simu18/SpyScan/hardware/README.md

# hardware

Placeholder — content is added in the corresponding project stage (see docs/plan/WORK_PLAN.md).
