simu18/SpyScan/firmware/README.md

# firmware

Placeholder — content is added in the corresponding project stage (see docs/plan/WORK_PLAN.md).
