simu18/SpyScan/tools/README.md

# tools

Placeholder — content is added in the corresponding project stage (see docs/plan/WORK_PLAN.md).
