simu18/SpyScan/docs/architecture/README.md

# architecture

Placeholder — content is added in the corresponding project stage (see docs/plan/WORK_PLAN.md).
