simu18/SpyScan/docs/analysis/README.md

# analysis

Placeholder — content is added in the corresponding project stage (see docs/plan/WORK_PLAN.md).
