simu18/SpyScan/docs/architecture/img/01_hw_block.png

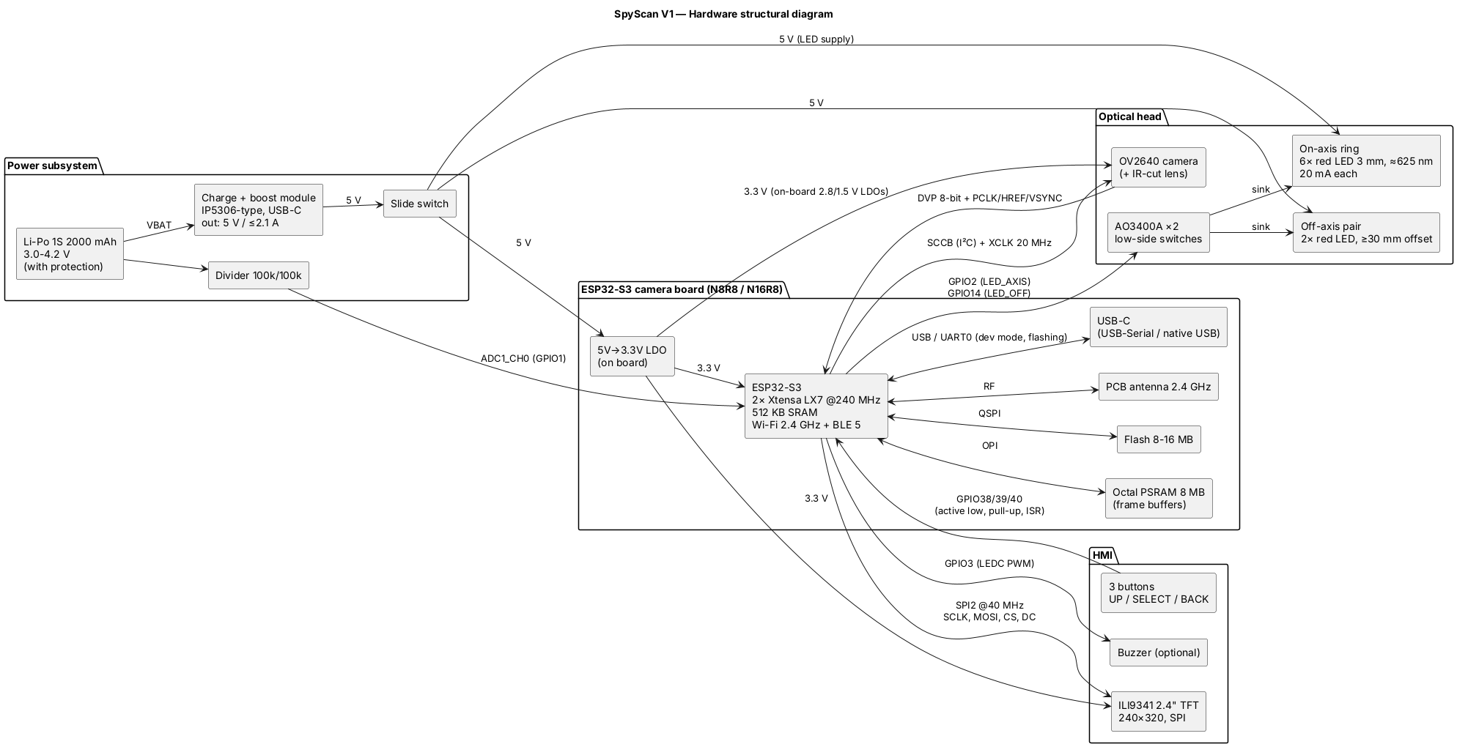
docs/architecture/img/01_hw_block.png
