simu18/SpyScan/docs/architecture/img/02_sw_modules.png

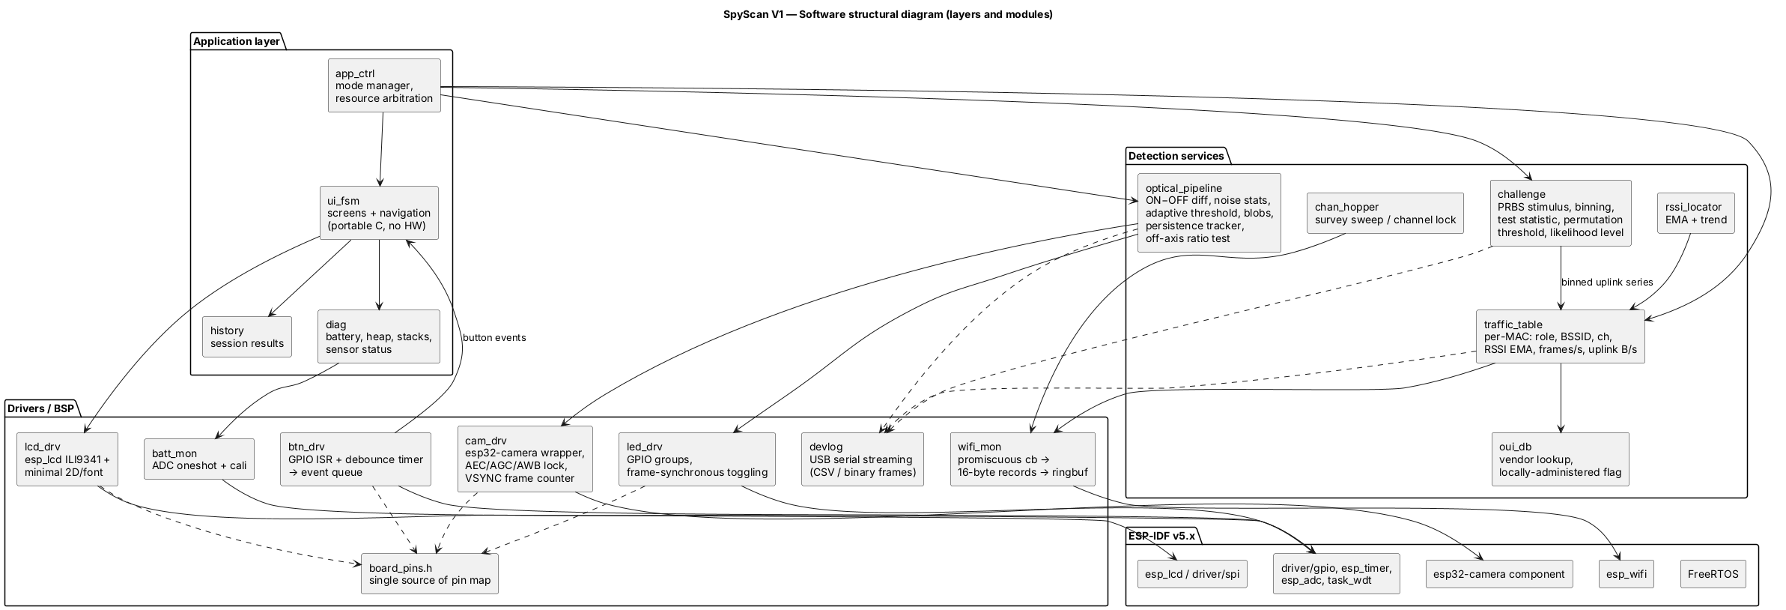
docs/architecture/img/02_sw_modules.png
