simu18/SpyScan/docs/architecture/img/03_rtos_tasks.png

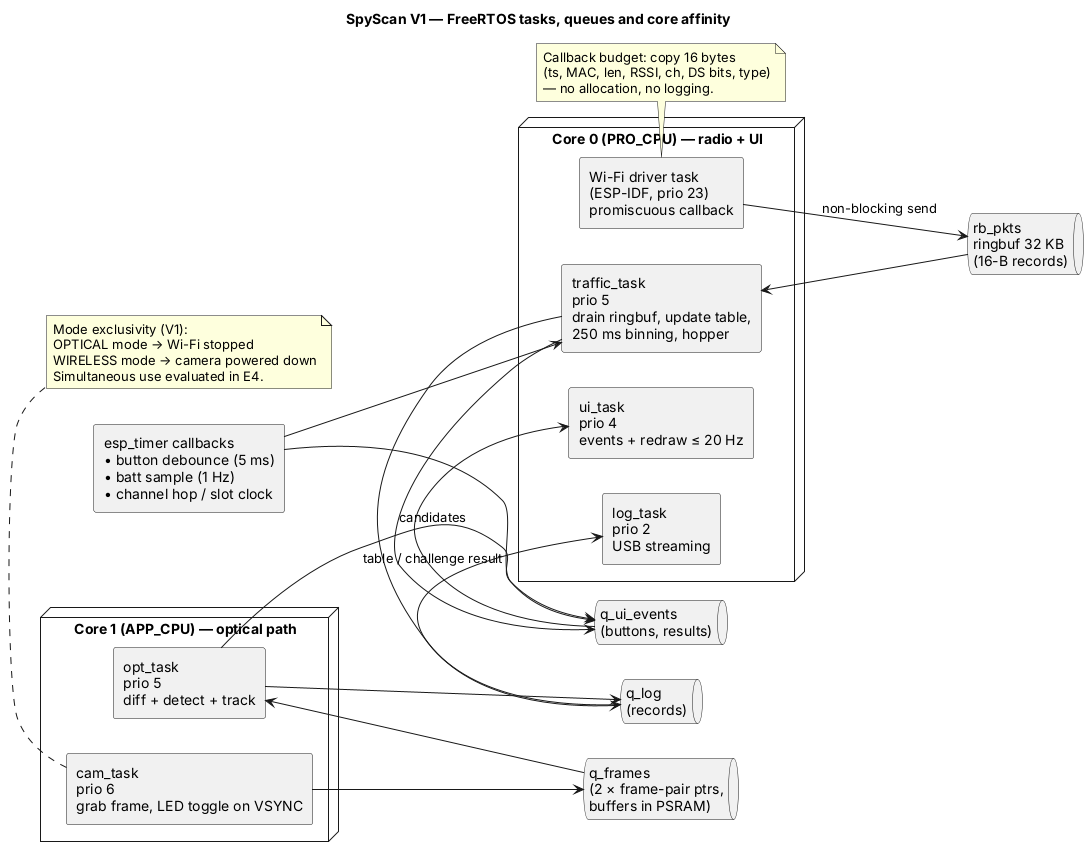
docs/architecture/img/03_rtos_tasks.png
