simu18/SpyScan/docs/architecture/img/04_seq_optical.png

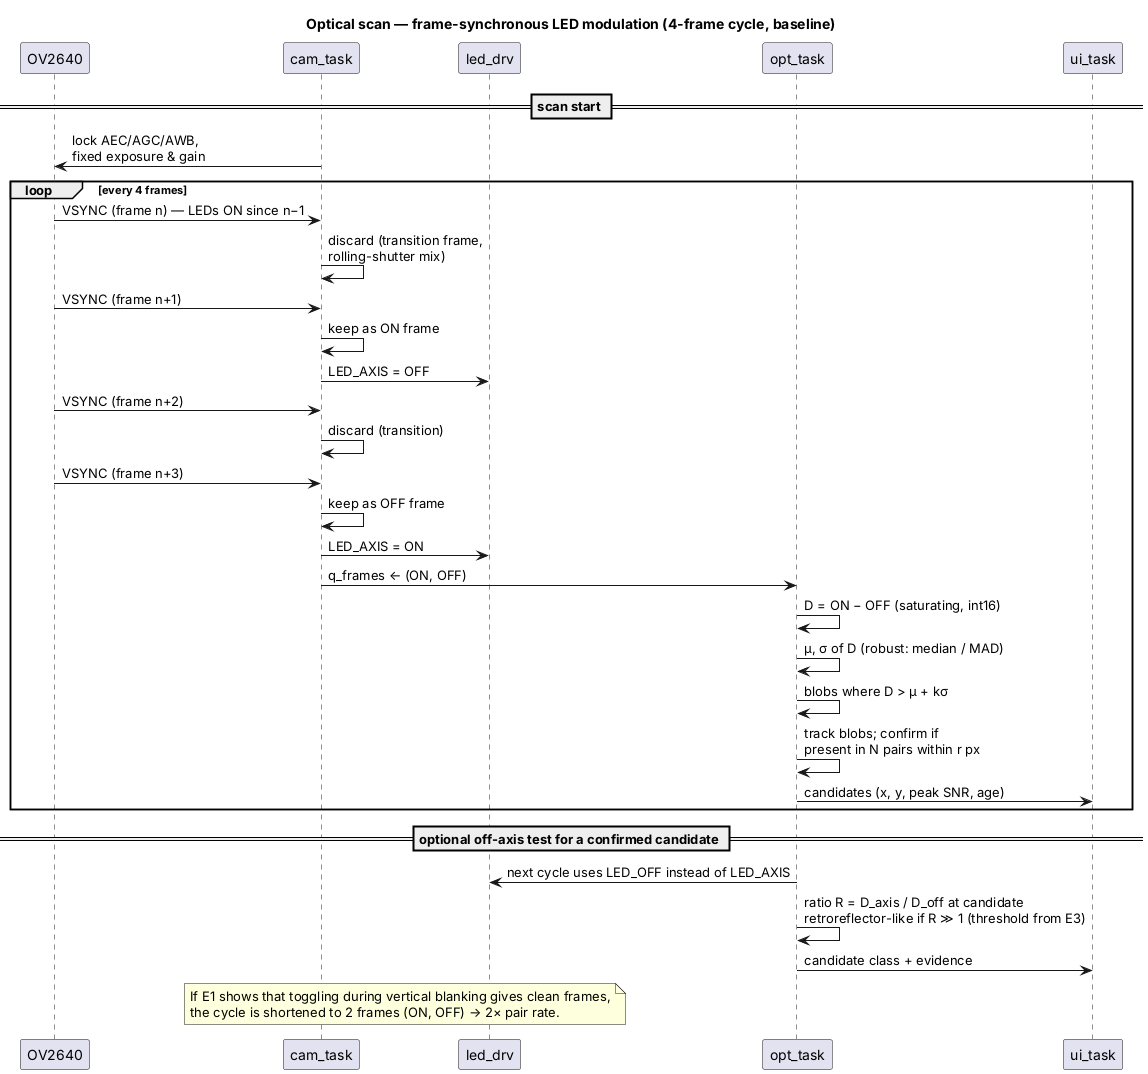
docs/architecture/img/04_seq_optical.png
