simu18/SpyScan/docs/architecture/img/05_seq_challenge.png

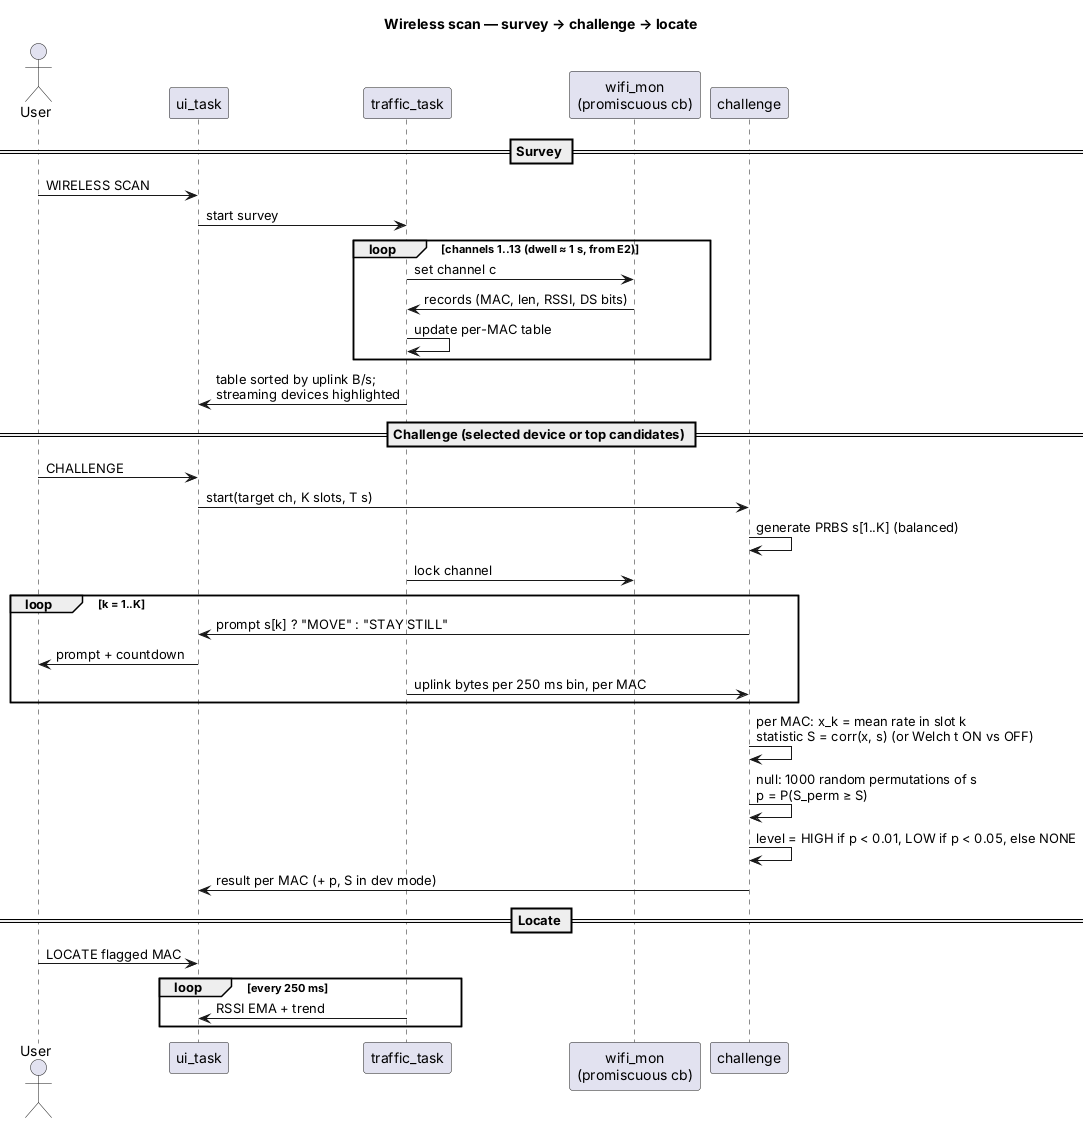
docs/architecture/img/05_seq_challenge.png
