simu18/SpyScan/docs/architecture/img/06_ui_fsm.png

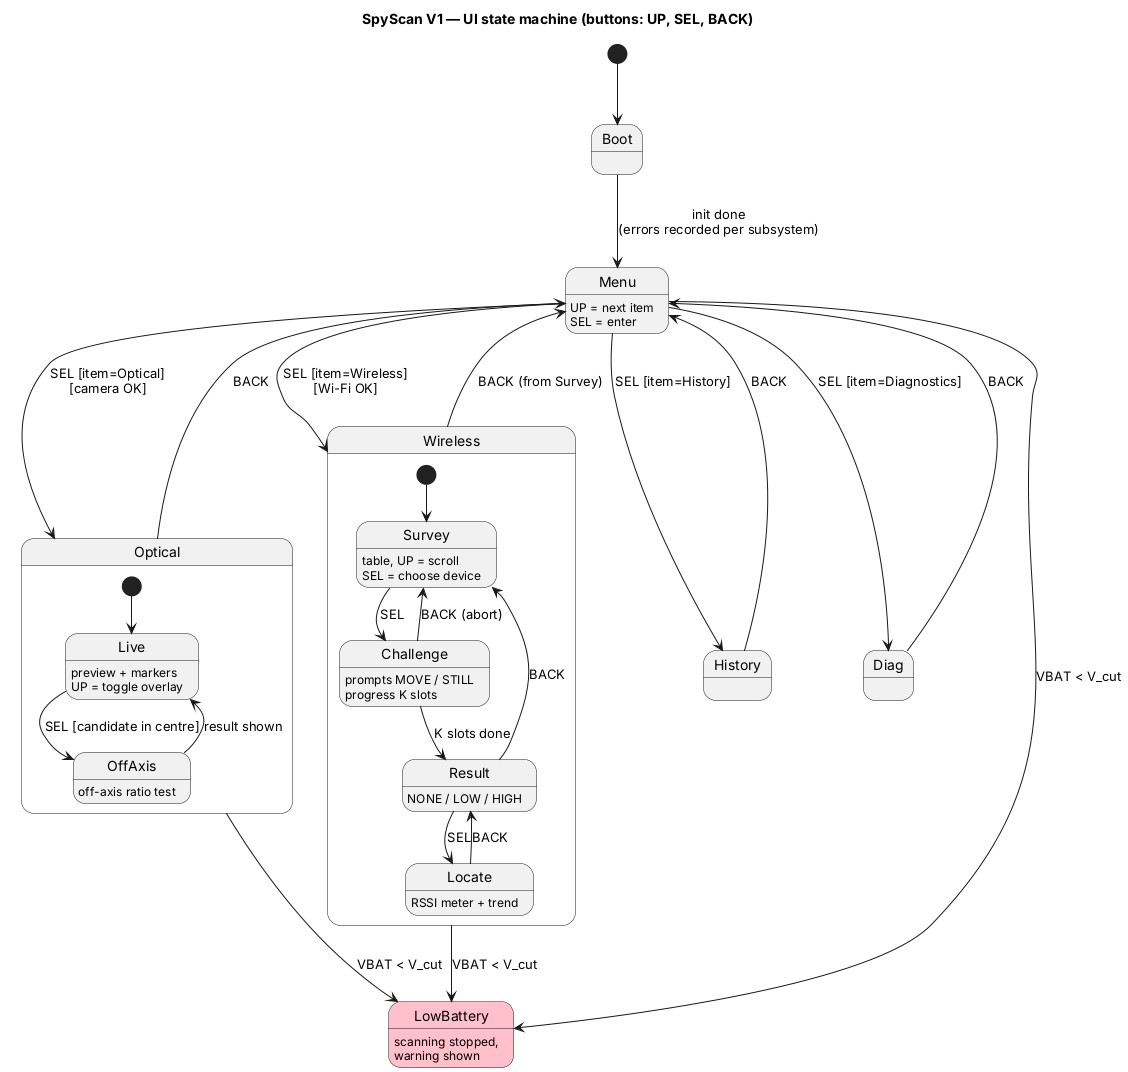
docs/architecture/img/06_ui_fsm.png
