simu18/SpyScan/hardware/spyscan_back_shell.stl

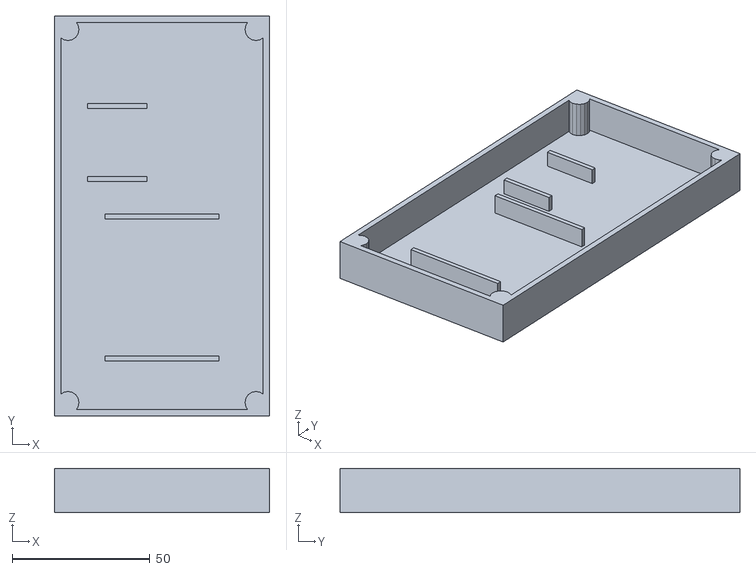
[picture p10: CAD file, 2026-11-08]
hardware/spyscan_back_shell.stl
78.0 x 145.0 x 16.0
