simu18/SpyScan/experiments/E2_wifi_traffic/data/20261023_030848_flash_stimulus/RESULTS.md

# Method 1: Optical-to-Wi-Fi Flash Stimulus Verification

- Target MAC: `cc:b8:5e:ad:5c:4a`
- Channel: 10
- Trials: 1
- Baseline Bitrate: **1.0 kB/s**
- Peak Post-Flash Bitrate: **2.8 kB/s** (+2.67×)
- Latency: **50 ms**
- Permutation p-value: **0.0307**

### Verdict: **CORRELATED (Optical Sensor belongs to Wi-Fi Transmitter)**
