simu18/SpyScan/experiments/E2_wifi_traffic/data/20261008_225613_record/RESULTS.md

# E2 run `20261008_225613_record`

- mode: **record**, channel: 10, bin: 100 ms, lines: 796
- duration: 20.7 s, devices seen: 8, APs: 13

## Busiest transmitters

| MAC | vendor hint | role | ch | tx kB/s | rx kB/s | tx frames | RSSI |
|---|---|---|---|---|---|---|---|
| `46:88:44:6e:4f:e4` | (random) | S | 10 | 55.39 | 0.03 | 1631 | -30 |
| `5c:62:8b:66:67:d2` |  | A | 10 | 3.28 | 56.68 | 89 | -48 |
| `72:3b:01:24:b7:c8` | (random) | S | 10 | 0.89 | 3.25 | 659 | -21 |
| `b2:db:ca:e6:29:a6` | (random) | S | 10 | 0.40 | 0.00 | 295 | -27 |
| `a6:4c:bd:b6:c7:99` | (random) | S | 10 | 0.09 | 0.00 | 32 | -88 |
| `78:8c:b5:f5:e7:26` |  | A | 10 | 0.03 | 0.10 | 6 | -74 |
| `64:d1:54:63:44:f4` |  | A | 10 | 0.01 | 0.00 | 3 | -86 |
| `00:08:22:24:d6:fb` |  | S | 10 | 0.00 | 0.00 | 1 | -86 |
