simu18/SpyScan/experiments/E2_wifi_traffic/data/20261023_023756_flash_stimulus/RESULTS.md

# Method 1: Optical-to-Wi-Fi Flash Stimulus Verification

- Target MAC: `cc:b8:5e:ad:5c:4a`
- Channel: 10
- Trials: 6
- Baseline Bitrate: **146.6 kB/s**
- Peak Post-Flash Bitrate: **206.7 kB/s** (+1.41×)
- Latency: **150 ms**
- Permutation p-value: **0.6500**

### Verdict: **UNCORRELATED (No significant bitrate spike observed)**
