simu18/SpyScan/experiments/E2_wifi_traffic/data/20261008_225257_challenge/RESULTS.md

# E2 run `20261008_225257_challenge`

- mode: **challenge**, channel: 10, bin: 100 ms, lines: 3647
- duration: 82.5 s, devices seen: 17, APs: 13

## Busiest transmitters

| MAC | vendor hint | role | ch | tx kB/s | rx kB/s | tx frames | RSSI |
|---|---|---|---|---|---|---|---|
| `46:88:44:6e:4f:e4` | (random) | S | 10 | 53.75 | 0.04 | 6409 | -28 |
| `5c:62:8b:66:67:d2` |  | A | 10 | 20.59 | 55.12 | 1558 | -48 |
| `72:3b:01:24:b7:c8` | (random) | S | 10 | 0.88 | 6.12 | 2604 | -21 |
| `78:8c:b5:f5:e7:26` |  | A | 10 | 0.87 | 0.19 | 83 | -73 |
| `b2:db:ca:e6:29:a6` | (random) | S | 10 | 0.48 | 14.43 | 1353 | -28 |
| `a6:4c:bd:b6:c7:99` | (random) | S | 10 | 0.18 | 0.81 | 360 | -84 |
| `80:af:ca:68:4c:f8` |  | A | 10 | 0.02 | 0.00 | 13 | -84 |
| `00:08:22:24:d6:fb` |  | S | 10 | 0.01 | 0.00 | 16 | -86 |
| `38:d5:7a:f4:5a:37` |  | S | 10 | 0.01 | 0.00 | 18 | -93 |
| `64:d1:54:63:44:f4` |  | A | 10 | 0.00 | 0.00 | 2 | -86 |
| `f4:28:9d:ce:e6:09` |  | S | 1 | 0.00 | 0.00 | 5 | -83 |
| `08:9d:f4:81:f5:38` |  | S | 1 | 0.00 | 0.00 | 2 | -87 |

## Challenge (K = 12, T = 5.0 s, lag = 0 ms, 10000 permutations)

Stimulus: `110101100001`

| MAC | vendor | S (corr) | p | level | tx ON kB/s | tx OFF kB/s | ON/OFF | direction |
|---|---|---|---|---|---|---|---|---|
| `78:8c:b5:f5:e7:26` |  | +0.377 | 0.1246 | **NONE** | 0.10 | 0.05 | 2.20 | - |
| `46:88:44:6e:4f:e4` | (random) | +0.058 | 0.4247 | **NONE** | 55.03 | 54.76 | 1.00 | - |
| `72:3b:01:24:b7:c8` | (random) | -0.029 | 0.5358 | **NONE** | 0.85 | 0.85 | 0.99 | - |
| `5c:62:8b:66:67:d2` |  | -0.290 | 0.6460 | **NONE** | 2.37 | 40.85 | 0.06 | - |
| `a6:4c:bd:b6:c7:99` | (random) | -0.147 | 0.7022 | **NONE** | 0.14 | 0.18 | 0.77 | - |
| `b2:db:ca:e6:29:a6` | (random) | -0.444 | 0.9559 | **NONE** | 0.43 | 0.52 | 0.82 | - |

*Measured data from this run. Levels use the pre-registered lag; lag.png is exploratory only.*

## Per-slot uplink (kB/s) and validity checks

| MAC | 0* | 1* | 2 | 3* | 4 | 5* | 6* | 7 | 8 | 9 | 10 | 11* | trend ρ | dropouts |
|---|---|---|---|---|---|---|---|---|---|---|---|---|---|---|
| `78:8c:b5:f5:e7:26` | 0 | 0 | 0 | 0 | 0 | 0 | 0 | 0 | 0 | 0 | 0 | 0 | +0.11 | 0 |
| `46:88:44:6e:4f:e4` | 55 | 54 | 51 | 57 | 58 | 58 | 52 | 57 | 55 | 56 | 52 | 54 | -0.01 | 0 |
| `72:3b:01:24:b7:c8` | 1 | 1 | 1 | 1 | 1 | 1 | 1 | 1 | 1 | 1 | 1 | 1 | -0.28 | 0 |
| `5c:62:8b:66:67:d2` | 11 | 0 | 0 | 2 | 0 | 0 | 1 | 0 | 2 | 242 | 1 | 0 | +0.26 | 0 |

`*` = MOVE/ON slot.
