simu18/SpyScan/experiments/E2_wifi_traffic/data/20261007_194153_record/RESULTS.md

# E2 run `20261007_194153_record`

- mode: **record**, channel: 10, bin: 100 ms, lines: 575
- duration: 20.9 s, devices seen: 8, APs: 9

## Busiest transmitters

| MAC | vendor hint | role | ch | tx kB/s | rx kB/s | tx frames | RSSI |
|---|---|---|---|---|---|---|---|
| `72:3b:01:24:b7:c8` | (random) | S | 10 | 232.60 | 0.00 | 4935 | -43 |
| `b2:db:ca:e6:29:a6` | (random) | S | 10 | 0.44 | 0.00 | 227 | -39 |
| `38:d5:7a:f4:5a:37` |  | S | 10 | 0.03 | 0.00 | 18 | -94 |
| `f4:28:9d:ce:e6:09` |  | S | 1 | 0.01 | 0.00 | 5 | -84 |
| `80:af:ca:68:4c:f8` |  | A | 10 | 0.00 | 0.00 | 1 | -83 |
| `46:fb:cf:a9:f4:22` | (random) | A | 10 | 0.00 | 0.03 | 0 | nan |
| `5c:62:8b:66:67:d2` |  | A | 10 | 0.00 | 233.04 | 0 | -50 |
| `c4:16:88:9a:06:5c` |  | A | 1 | 0.00 | 0.01 | 0 | nan |
