simu18/SpyScan/experiments/E2_wifi_traffic/data/20261007_195253_record/RESULTS.md

# E2 run `20261007_195253_record`

- mode: **record**, channel: 10, bin: 100 ms, lines: 529
- duration: 20.9 s, devices seen: 8, APs: 8

## Busiest transmitters

| MAC | vendor hint | role | ch | tx kB/s | rx kB/s | tx frames | RSSI |
|---|---|---|---|---|---|---|---|
| `5c:62:8b:66:67:d2` |  | A | 10 | 10.43 | 0.74 | 283 | -54 |
| `72:3b:01:24:b7:c8` | (random) | S | 10 | 0.43 | 10.41 | 320 | -36 |
| `b2:db:ca:e6:29:a6` | (random) | S | 10 | 0.30 | 0.00 | 226 | -37 |
| `38:d5:7a:f4:5a:37` |  | S | 10 | 0.06 | 0.00 | 39 | -92 |
| `80:af:ca:68:4c:f8` |  | A | 10 | 0.01 | 0.00 | 3 | -81 |
| `f4:28:9d:ce:e6:09` |  | S | 1 | 0.00 | 0.00 | 3 | -82 |
| `46:fb:cf:a9:f4:22` | (random) | A | 10 | 0.00 | 0.06 | 0 | nan |
| `c4:16:88:9a:06:5c` |  | A | 1 | 0.00 | 0.00 | 0 | nan |
