simu18/SpyScan/experiments/E2_wifi_traffic/data/20261007_200102_record/RESULTS.md

# E2 run `20261007_200102_record`

- mode: **record**, channel: 10, bin: 100 ms, lines: 253
- duration: 10.7 s, devices seen: 7, APs: 11

## Busiest transmitters

| MAC | vendor hint | role | ch | tx kB/s | rx kB/s | tx frames | RSSI |
|---|---|---|---|---|---|---|---|
| `72:3b:01:24:b7:c8` | (random) | S | 10 | 0.97 | 0.00 | 195 | -40 |
| `b2:db:ca:e6:29:a6` | (random) | S | 10 | 0.28 | 0.00 | 106 | -34 |
| `38:d5:7a:f4:5a:37` |  | S | 10 | 0.04 | 0.00 | 15 | -91 |
| `f4:28:9d:ce:e6:09` |  | S | 1 | 0.01 | 0.00 | 4 | -83 |
| `46:fb:cf:a9:f4:22` | (random) | A | 10 | 0.00 | 0.04 | 0 | nan |
| `5c:62:8b:66:67:d2` |  | A | 10 | 0.00 | 1.24 | 0 | -51 |
| `c4:16:88:9a:06:5c` |  | A | 1 | 0.00 | 0.01 | 0 | -86 |
