simu18/SpyScan/experiments/E2_wifi_traffic/data/20261007_165052_survey/RESULTS.md

# E2 run `20261007_165052_survey`

- mode: **survey**, channel: hop, bin: 100 ms, lines: 286
- duration: 40.1 s, devices seen: 18, APs: 28

## Busiest transmitters

| MAC | vendor hint | role | ch | tx kB/s | rx kB/s | tx frames | RSSI |
|---|---|---|---|---|---|---|---|
| `cc:d8:43:ca:9f:eb` |  | A | 1 | 21.02 | 3.83 | 594 | -80 |
| `98:5f:41:bf:7c:ff` |  | S | 1 | 3.83 | 21.02 | 806 | -71 |
| `b2:db:ca:e6:29:a6` | (random) | S | 10 | 0.03 | 0.00 | 37 | -31 |
| `f2:51:4e:f8:1a:7f` | (random) | S | 10 | 0.02 | 0.00 | 28 | -91 |
| `80:af:ca:68:4c:f8` |  | A | 9 | 0.02 | 0.00 | 2 | -89 |
| `c2:a5:dd:1b:60:3b` | (random) | A | 1 | 0.02 | 0.01 | 5 | -71 |
| `d4:9c:53:19:89:bd` |  | A | 4 | 0.01 | 0.00 | 3 | -92 |
| `5a:62:f6:96:2d:4c` | (random) | S | 1 | 0.01 | 0.00 | 15 | -80 |
| `5c:62:8b:66:67:d2` |  | A | 10 | 0.01 | 0.03 | 3 | -47 |
| `72:3b:01:24:b7:c8` | (random) | S | 10 | 0.01 | 0.00 | 12 | -32 |
| `ba:06:0d:93:c3:c8` | (random) | S | 5 | 0.00 | 0.00 | 7 | -82 |
| `d2:d8:fd:d6:99:6d` | (random) | S | 12 | 0.00 | 0.00 | 7 | -90 |
