simu18/SpyScan/experiments/E2_wifi_traffic/data/20261007_194041_survey/RESULTS.md

# E2 run `20261007_194041_survey`

- mode: **survey**, channel: hop, bin: 100 ms, lines: 256
- duration: 30.0 s, devices seen: 24, APs: 30
- survey rates are estimated per on-channel time (duration / 13); use `record` on one channel for accurate rates

## Busiest transmitters

| MAC | vendor hint | role | ch | tx kB/s | rx kB/s | tx frames | RSSI |
|---|---|---|---|---|---|---|---|
| `98:5f:41:bf:7c:ff` |  | S | 1 | 9.29 | 8.66 | 128 | -71 |
| `cc:d8:43:ca:9f:eb` |  | A | 1 | 8.66 | 9.29 | 13 | -85 |
| `e6:eb:0e:16:9b:da` | (random) | A | 6 | 4.51 | 2.81 | 27 | -53 |
| `6a:00:a8:6f:a4:98` | (random) | S | 6 | 2.81 | 4.51 | 38 | -52 |
| `72:3b:01:24:b7:c8` | (random) | S | 10 | 1.17 | 0.00 | 54 | -42 |
| `f4:28:9d:ce:e6:09` |  | S | 1 | 0.49 | 0.00 | 40 | -86 |
| `a6:4c:bd:b6:c7:99` | (random) | S | 4 | 0.30 | 0.00 | 14 | -78 |
| `b2:db:ca:e6:29:a6` | (random) | S | 10 | 0.28 | 0.16 | 23 | -39 |
| `24:0f:5e:01:73:b6` |  | A | 3 | 0.27 | 0.00 | 4 | -48 |
| `5c:62:8b:66:67:d2` |  | A | 10 | 0.16 | 1.45 | 1 | -51 |
| `80:af:ca:68:4c:f8` |  | A | 9 | 0.11 | 0.00 | 1 | -85 |
| `86:a9:6f:45:bc:72` | (random) | S | 7 | 0.10 | 0.00 | 8 | -86 |
