simu18/SpyScan/experiments/E2_wifi_traffic/data/20261007_201546_survey/RESULTS.md

# E2 run `20261007_201546_survey`

- mode: **survey**, channel: hop, bin: 100 ms, lines: 295
- duration: 29.6 s, devices seen: 16, APs: 25
- survey rates are estimated per on-channel time (duration / 13); use `record` on one channel for accurate rates

## Busiest transmitters

| MAC | vendor hint | role | ch | tx kB/s | rx kB/s | tx frames | RSSI |
|---|---|---|---|---|---|---|---|
| `5c:62:8b:66:67:d2` |  | A | 10 | 111.05 | 33.77 | 486 | -47 |
| `e6:eb:0e:16:9b:da` | (random) | A | 6 | 34.11 | 7.55 | 109 | -50 |
| `b2:db:ca:e6:29:a6` | (random) | S | 10 | 33.68 | 111.05 | 213 | -36 |
| `6a:00:a8:6f:a4:98` | (random) | S | 6 | 7.55 | 34.11 | 125 | -51 |
| `f4:28:9d:ce:e6:09` |  | S | 1 | 0.93 | 0.00 | 75 | -84 |
| `98:5f:41:bf:7c:ff` |  | S | 1 | 0.86 | 0.00 | 10 | -69 |
| `46:c9:85:5c:85:9c` | (random) | S | 1 | 0.58 | 0.00 | 47 | -80 |
| `44:df:65:f4:66:07` |  | A | 1 | 0.38 | 0.00 | 5 | -88 |
| `cc:d8:43:ca:9f:eb` |  | A | 1 | 0.18 | 0.86 | 1 | -82 |
| `0c:ef:15:aa:11:03` |  | A | 5 | 0.18 | 0.00 | 1 | -63 |
| `72:3b:01:24:b7:c8` | (random) | S | 10 | 0.10 | 0.00 | 8 | -37 |
| `78:8c:b5:f5:e7:26` |  | A | 4 | 0.06 | 0.00 | 1 | -74 |
