simu18/SpyScan/experiments/E2_wifi_traffic/data/20261007_201644_record/RESULTS.md

# E2 run `20261007_201644_record`

- mode: **record**, channel: 10, bin: 100 ms, lines: 558
- duration: 20.8 s, devices seen: 9, APs: 6

## Busiest transmitters

| MAC | vendor hint | role | ch | tx kB/s | rx kB/s | tx frames | RSSI |
|---|---|---|---|---|---|---|---|
| `b2:db:ca:e6:29:a6` | (random) | S | 10 | 28.16 | 6.56 | 3144 | -35 |
| `5c:62:8b:66:67:d2` |  | A | 10 | 6.56 | 28.70 | 502 | -50 |
| `72:3b:01:24:b7:c8` | (random) | S | 10 | 0.54 | 0.00 | 397 | -38 |
| `46:c9:85:5c:85:9c` | (random) | S | 1 | 0.01 | 0.00 | 6 | -78 |
| `98:5f:41:bf:7c:ff` |  | S | 1 | 0.01 | 0.00 | 1 | -70 |
| `f4:28:9d:ce:e6:09` |  | S | 1 | 0.00 | 0.00 | 2 | -87 |
| `c2:a5:dd:1b:60:3b` | (random) | A | 1 | 0.00 | 0.01 | 0 | -64 |
| `c4:16:88:9a:06:5c` |  | A | 1 | 0.00 | 0.00 | 0 | -87 |
| `cc:d8:43:ca:9f:eb` |  | A | 1 | 0.00 | 0.01 | 0 | nan |
