simu18/SpyScan/experiments/E2_wifi_traffic/data/20261007_202335_record/RESULTS.md

# E2 run `20261007_202335_record`

- mode: **record**, channel: 10, bin: 100 ms, lines: 251
- duration: 10.8 s, devices seen: 9, APs: 8

## Busiest transmitters

| MAC | vendor hint | role | ch | tx kB/s | rx kB/s | tx frames | RSSI |
|---|---|---|---|---|---|---|---|
| `72:3b:01:24:b7:c8` | (random) | S | 10 | 0.44 | 0.00 | 169 | -44 |
| `b2:db:ca:e6:29:a6` | (random) | S | 10 | 0.32 | 0.00 | 123 | -30 |
| `d2:cf:53:d5:b8:26` | (random) | S | 10 | 0.01 | 0.00 | 5 | -89 |
| `c2:a5:dd:1b:60:3b` | (random) | A | 1 | 0.01 | 0.00 | 1 | -75 |
| `f4:28:9d:ce:e6:09` |  | S | 1 | 0.01 | 0.00 | 2 | -88 |
| `2c:0d:a7:d7:7c:3d` |  | S | 1 | 0.00 | 0.01 | 0 | nan |
| `46:fb:cf:a9:f4:22` | (random) | A | 10 | 0.00 | 0.01 | 0 | nan |
| `5c:62:8b:66:67:d2` |  | A | 10 | 0.00 | 0.76 | 0 | -52 |
| `c4:16:88:9a:06:5c` |  | A | 1 | 0.00 | 0.01 | 0 | -88 |
