simu18/SpyScan/experiments/E2_wifi_traffic/data/20261007_165052_survey/aps.csv

t_ms | ch | bssid | rssi | ssid
101276 | 3 | 24:0f:5e:01:73:b6 | -51 | vovi_apart
102127 | 4 | e0:bb:0c:07:63:0b | -82 | LevieEnRose
102265 | 5 | b4:e8:42:c0:e9:6a | -54 | LEDnet0033C0E96A
102268 | 5 | 0c:ef:15:aa:11:03 | -52 | TP-Link_1103
102275 | 5 | 0e:ef:15:aa:11:03 | -51
102313 | 5 | 2c:07:86:00:4a:14 | -87 | HUAWEI-GE1Y5P
102350 | 5 | f4:f2:6d:20:fc:84 | -61 | vassago27
103649 | 7 | 40:ae:30:36:19:ea | -73 | 1606
103794 | 8 | 50:ff:20:d0:72:b3 | -88 | Keenetic-5193
104350 | 9 | 80:af:ca:68:4c:f8 | -86 | Cudy-4CF8
104354 | 9 | 82:af:ca:28:4c:f8 | -85
104847 | 10 | 5c:62:8b:66:67:d2 | -41 | TP-Link_67D2
105156 | 10 | d8:0d:17:46:46:1a | -62 | spike
105320 | 11 | 00:eb:d8:11:99:9d | -63
105322 | 11 | 02:eb:d8:11:99:9d | -63
105468 | 11 | e0:bb:0c:05:3a:69 | -86 | 528
105515 | 11 | ba:97:a3:e0:bf:91 | -95
109842 | 7 | 46:ae:30:36:19:ea | -73
109873 | 7 | 4c:50:77:04:54:a5 | -86
109886 | 7 | 4c:50:77:04:54:a2 | -87 | HataZDrugovoKrayu
110896 | 9 | 50:ff:20:c0:de:c7 | -90 | Keenetic-5193
111458 | 10 | b0:a7:b9:23:82:ee | -90 | ________ __ ________
112162 | 11 | b8:ec:a3:e0:bf:97 | -96 | KV 15
118413 | 11 | ba:97:a3:e0:bf:9f | -94
118887 | 12 | 88:d7:f6:5f:c8:14 | -91 | 1605
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
