simu18/SpyScan/experiments/E2_wifi_traffic/data/20261007_165052_survey/devices.csv

mac | tx_kBps | rx_kBps | tx_frames | rx_frames | rssi_med | role | bssid | ch | vendor
cc:d8:43:ca:9f:eb | 21.017456359102244 | 3.83211970074813 | 594 | 811 | -80.0 | A | cc:d8:43:ca:9f:eb | 1
98:5f:41:bf:7c:ff | 3.8286284289276806 | 21.017456359102244 | 806 | 594 | -71.0 | S | cc:d8:43:ca:9f:eb | 1
b2:db:ca:e6:29:a6 | 0.025835411471321696 | 0.0 | 37 | 0 | -31.0 | S | 5c:62:8b:66:67:d2 | 10 | (random)
f2:51:4e:f8:1a:7f | 0.020947630922693267 | 0.0 | 28 | 0 | -91.0 | S | b0:a7:b9:23:82:ee | 10 | (random)
80:af:ca:68:4c:f8 | 0.01623441396508728 | 0.0 | 2 | 0 | -89.0 | A | 80:af:ca:68:4c:f8 | 9
c2:a5:dd:1b:60:3b | 0.015561097256857854 | 0.010972568578553617 | 5 | 15 | -71.0 | A | c2:a5:dd:1b:60:3b | 1 | (random)
d4:9c:53:19:89:bd | 0.01167082294264339 | 0.0 | 3 | 0 | -92.5 | A | d4:9c:53:19:89:bd | 4
5a:62:f6:96:2d:4c | 0.010972568578553617 | 0.0 | 15 | 0 | -80.0 | S | c2:a5:dd:1b:60:3b | 1 | (random)
5c:62:8b:66:67:d2 | 0.009900249376558604 | 0.034214463840399 | 3 | 49 | -47.0 | A | 5c:62:8b:66:67:d2 | 10
72:3b:01:24:b7:c8 | 0.008379052369077307 | 0.0 | 12 | 0 | -31.5 | S | 5c:62:8b:66:67:d2 | 10 | (random)
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
