simu18/SpyScan/experiments/E2_wifi_traffic/data/20261007_165052_survey/raw.csv

host_time_s | line
1791381052.238 | B,100288,1,98:5f:41:bf:7c:ff,5198,29,10290,7,-72,S,cc:d8:43:ca:9f:eb
1791381052.238 | B,100288,1,cc:d8:43:ca:9f:eb,10290,7,5198,29,-81,A,cc:d8:43:ca:9f:eb
1791381052.238 | B,100388,1,98:5f:41:bf:7c:ff,4946,27,6092,4,-72,S,cc:d8:43:ca:9f:eb
1791381052.238 | B,100388,1,cc:d8:43:ca:9f:eb,6092,4,4946,27,-81,A,cc:d8:43:ca:9f:eb
1791381052.443 | B,100488,1,98:5f:41:bf:7c:ff,5064,28,14226,11,-72,S,cc:d8:43:ca:9f:eb
1791381052.443 | B,100488,1,cc:d8:43:ca:9f:eb,14226,11,5064,28,-81,A,cc:d8:43:ca:9f:eb
1791381052.443 | B,100588,1,98:5f:41:bf:7c:ff,6520,36,13206,9,-72,S,cc:d8:43:ca:9f:eb
1791381052.443 | B,100588,1,cc:d8:43:ca:9f:eb,13206,9,6520,36,-81,A,cc:d8:43:ca:9f:eb
1791381052.647 | B,100688,1,98:5f:41:bf:7c:ff,6868,38,10766,7,-71,S,cc:d8:43:ca:9f:eb
1791381052.647 | B,100688,1,cc:d8:43:ca:9f:eb,10766,7,6868,38,-81,A,cc:d8:43:ca:9f:eb
1791381052.647 | B,100688,1,c2:a5:dd:1b:60:3b,0,0,30,1,-72,A,c2:a5:dd:1b:60:3b
1791381052.647 | B,100688,1,5a:62:f6:96:2d:4c,30,1,0,0,-83,S,c2:a5:dd:1b:60:3b
1791381052.647 | I,100754,bin,100
1791381052.647 | I,100754,hop,500
1791381052.647 | B,100788,1,98:5f:41:bf:7c:ff,3442,19,7968,6,-71,S,cc:d8:43:ca:9f:eb
1791381052.647 | B,100788,1,cc:d8:43:ca:9f:eb,7968,6,3442,19,-81,A,cc:d8:43:ca:9f:eb
1791381052.848 | B,100988,1,98:5f:41:bf:7c:ff,0,0,1538,1,0,S,cc:d8:43:ca:9f:eb
1791381052.848 | B,100988,2,cc:d8:43:ca:9f:eb,1538,1,0,0,-83,A,cc:d8:43:ca:9f:eb
1791381053.254 | A,101276,3,24:0f:5e:01:73:b6,-51,vovi_apart
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
1791381092.351 | B,140388,2,cc:d8:43:ca:9f:eb,0,0,28,1,-78,A,cc:d8:43:ca:9f:eb
1791381092.351 | B,140388,2,26:5a:ee:af:90:48,28,1,0,0,-81,S,cc:d8:43:ca:9f:eb
1791381092.953 | A,140976,4,78:8c:b5:f5:e7:26,-81,ITMO
1791381093.158 | A,141250,4,d4:9c:53:19:89:bd,-91,BIG_25
