simu18/SpyScan/experiments/E2_wifi_traffic/data/20261007_191143_challenge/raw.csv

host_time_s | line
1791389504.401 | I,76,boot,spyscan-e2-sniffer,v0.1,transport=usb-serial-jtag
1791389504.401 | A,84,1,cc:d8:43:ca:9f:eb,-81,Xiaomi_DF62
1791389504.401 | A,103,1,00:eb:d8:38:aa:a8,-86,1511
1791389504.401 | A,128,1,c4:16:88:9a:06:5c,-76,Marine_Horse
1791389504.401 | A,167,1,c2:a5:dd:1b:60:3b,-61,MERCURY_603B
1791389504.401 | A,176,1,44:df:65:f4:66:07,-85,logovo_SKUFov
1791389504.401 | B,176,1,4a:b8:09:80:b5:04,28,1,0,0,-92,S,ac:15:a2:99:fb:06
1791389504.401 | B,176,1,ac:15:a2:99:fb:06,0,0,28,1,0,A,ac:15:a2:99:fb:06
1791389504.605 | B,276,1,8a:c3:97:0c:72:ac,30,1,0,0,-95,S,ec:41:18:e6:15:46
1791389504.605 | B,276,1,ec:41:18:e6:15:46,0,0,30,1,0,A,ec:41:18:e6:15:46
1791389504.605 | I,332,reset
1791389504.605 | I,333,bin,100
1791389504.605 | A,333,1,c4:16:88:9a:06:5c,-79,Marine_Horse
1791389504.605 | I,334,channel,10
1791389504.605 | A,406,10,5c:62:8b:66:67:d2,-45,TP-Link_67D2
1791389504.805 | A,469,10,00:eb:d8:11:99:9d,-63,
1791389504.805 | B,476,10,b2:db:ca:e6:29:a6,56,2,0,0,-46,S,5c:62:8b:66:67:d2
1791389504.805 | B,476,10,5c:62:8b:66:67:d2,0,0,56,2,-45,A,5c:62:8b:66:67:d2
1791389504.805 | B,576,10,b2:db:ca:e6:29:a6,28,1,0,0,-46,S,5c:62:8b:66:67:d2
1791389504.805 | B,576,10,5c:62:8b:66:67:d2,0,0,28,1,-45,A,5c:62:8b:66:67:d2
1791389504.805 | M,638,baseline
1791389505.010 | A,658,10,80:af:ca:68:4c:f8,-80,Cudy-4CF8
1791389505.010 | B,676,10,b2:db:ca:e6:29:a6,84,3,0,0,-46,S,5c:62:8b:66:67:d2
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
1791389575.572 | B,71276,10,72:3b:01:24:b7:c8,28,1,0,0,-48,S,5c:62:8b:66:67:d2
1791389575.980 | M,71710,end
1791389577.000 | B,72776,10,38:d5:7a:f4:5a:37,30,1,0,0,-91,S,46:fb:cf:a9:f4:22
1791389577.000 | B,72776,10,46:fb:cf:a9:f4:22,0,0,30,1,-85,A,46:fb:cf:a9:f4:22
