simu18/SpyScan/experiments/E2_wifi_traffic/data/20261007_191525_challenge/raw.csv

host_time_s | line
1791389726.036 | I,80,boot,spyscan-e2-sniffer,v0.1,transport=usb-serial-jtag
1791389726.036 | A,97,1,00:eb:d8:38:aa:a8,-85,1511
1791389726.036 | A,123,1,c4:16:88:9a:06:5c,-80,Marine_Horse
1791389726.036 | A,161,1,c2:a5:dd:1b:60:3b,-59,MERCURY_603B
1791389726.036 | A,179,1,cc:d8:43:ca:9f:eb,-80,Xiaomi_DF62
1791389726.036 | B,180,1,c4:16:88:9a:06:5c,0,0,84,3,-80,A,c4:16:88:9a:06:5c
1791389726.036 | B,180,1,f4:28:9d:ce:e6:09,84,3,0,0,-84,S,c4:16:88:9a:06:5c
1791389726.241 | A,274,1,44:df:65:f4:66:07,-84,logovo_SKUFov
1791389726.241 | B,280,1,c4:16:88:9a:06:5c,0,0,84,3,0,A,c4:16:88:9a:06:5c
1791389726.241 | B,280,1,f4:28:9d:ce:e6:09,84,3,0,0,-84,S,c4:16:88:9a:06:5c
1791389726.241 | B,280,1,cc:d8:43:ca:9f:eb,0,0,166,1,-80,A,cc:d8:43:ca:9f:eb
1791389726.241 | B,280,1,98:5f:41:bf:7c:ff,166,1,0,0,-65,S,cc:d8:43:ca:9f:eb
1791389726.241 | I,332,reset
1791389726.241 | I,333,bin,100
1791389726.241 | I,333,channel,10
1791389726.241 | B,380,10,b2:db:ca:e6:29:a6,28,1,0,0,-46,S,5c:62:8b:66:67:d2
1791389726.241 | B,380,10,5c:62:8b:66:67:d2,0,0,140,5,0,A,5c:62:8b:66:67:d2
1791389726.241 | B,380,10,72:3b:01:24:b7:c8,112,4,0,0,-56,S,5c:62:8b:66:67:d2
1791389726.241 | A,400,10,5c:62:8b:66:67:d2,-49,TP-Link_67D2
1791389726.442 | A,446,10,80:af:ca:68:4c:f8,-78,Cudy-4CF8
1791389726.442 | B,480,10,5c:62:8b:66:67:d2,0,0,28,1,-49,A,5c:62:8b:66:67:d2
1791389726.442 | B,480,10,72:3b:01:24:b7:c8,28,1,0,0,-56,S,5c:62:8b:66:67:d2
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
1791389786.195 | B,60380,10,5c:62:8b:66:67:d2,0,0,56,2,-46,A,5c:62:8b:66:67:d2
1791389786.195 | B,60380,10,72:3b:01:24:b7:c8,56,2,0,0,-35,S,5c:62:8b:66:67:d2
1791389786.195 | B,60380,10,38:d5:7a:f4:5a:37,30,1,0,0,-95,S,46:fb:cf:a9:f4:22
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
