simu18/SpyScan/experiments/E2_wifi_traffic/data/20261008_225257_challenge/lag.png

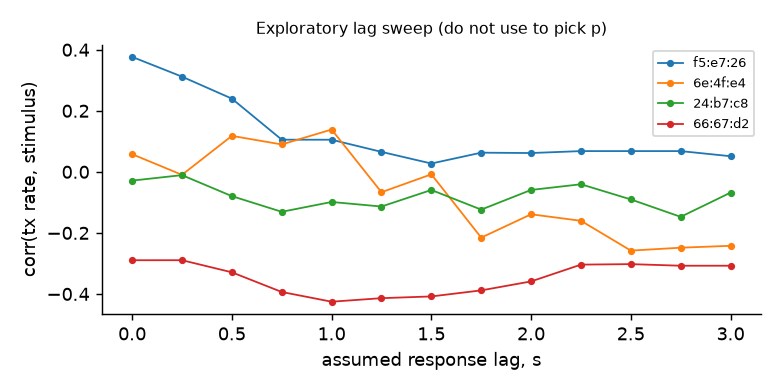
experiments/E2_wifi_traffic/data/20261008_225257_challenge/lag.png
