simu18/SpyScan/experiments/E2_wifi_traffic/data/20261008_225613_record/traffic.png

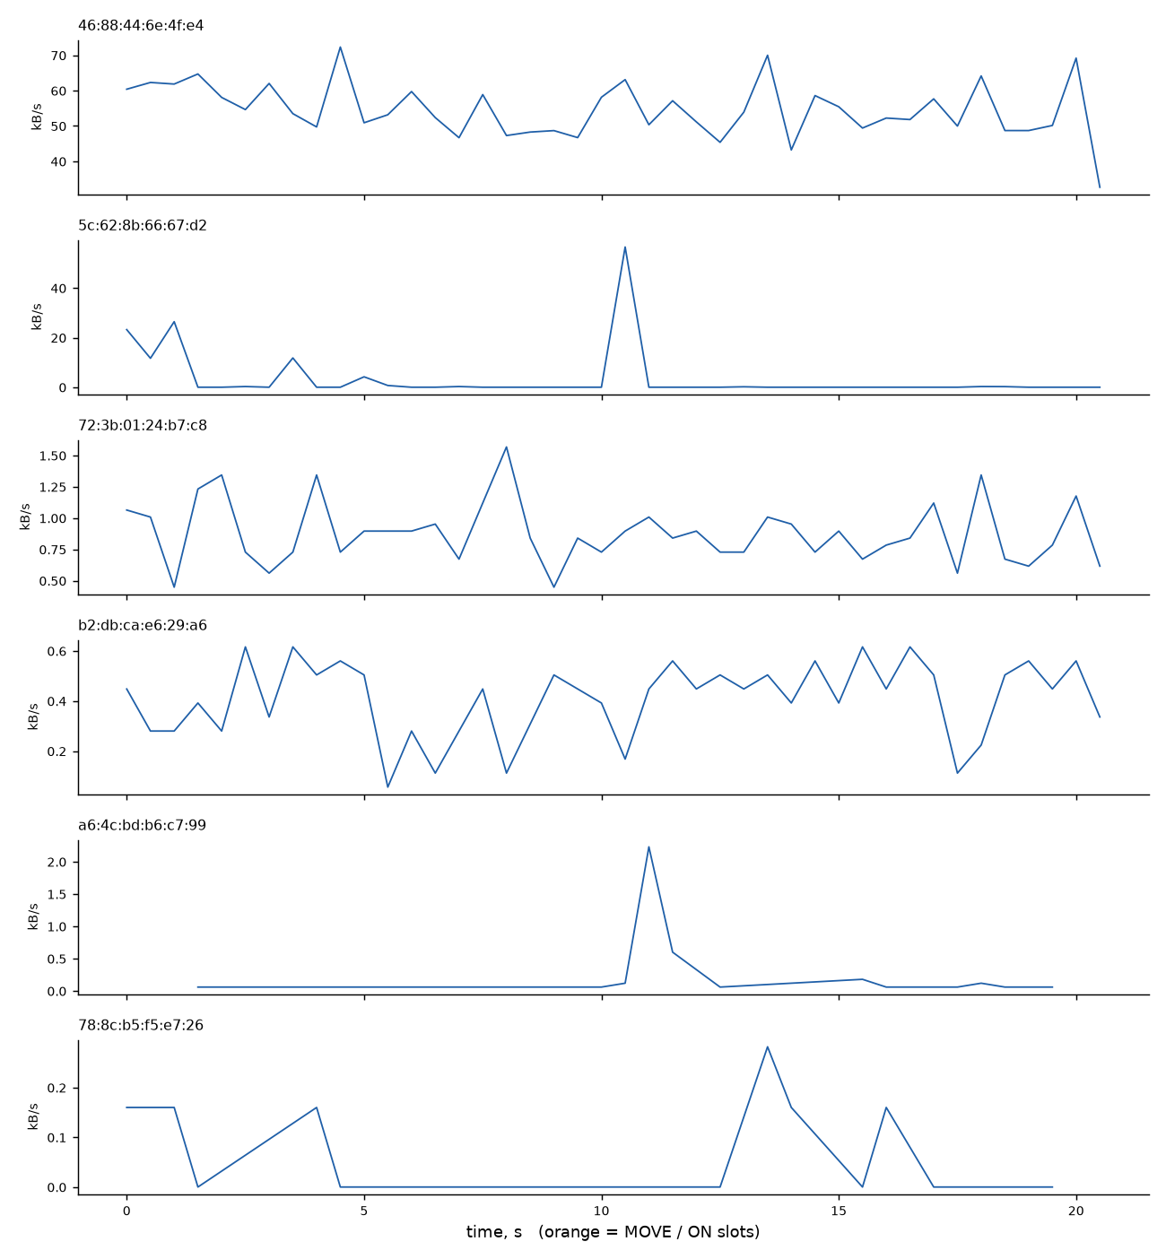
experiments/E2_wifi_traffic/data/20261008_225613_record/traffic.png
