simu18/SpyScan/experiments/E2_wifi_traffic/data/20261008_231450_challenge/lag.png

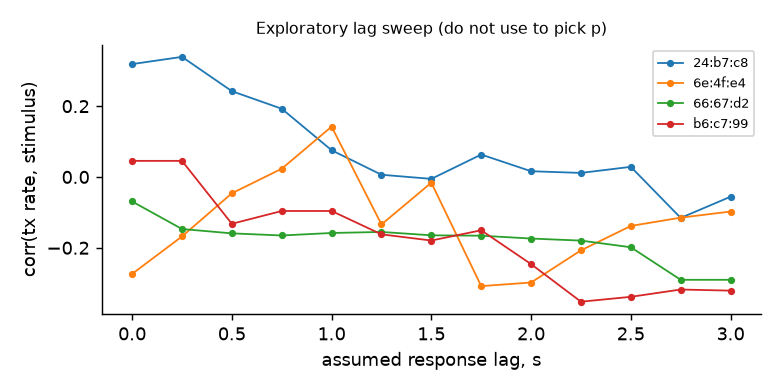
experiments/E2_wifi_traffic/data/20261008_231450_challenge/lag.png
