simu18/SpyScan/experiments/E2_wifi_traffic/data/20261008_231726_challenge/lag.png

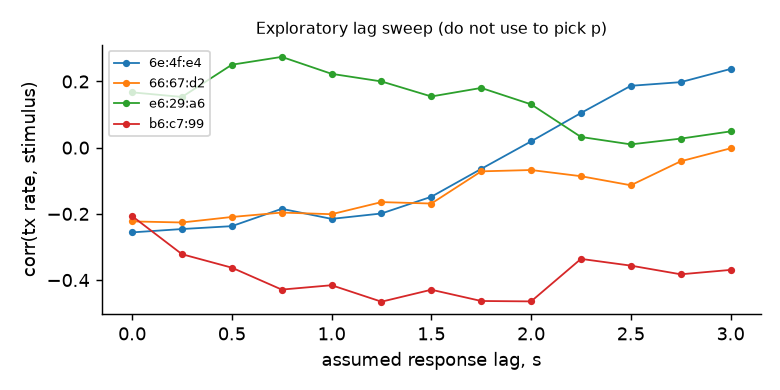
experiments/E2_wifi_traffic/data/20261008_231726_challenge/lag.png
