simu18/SpyScan/experiments/E2_wifi_traffic/data/20261009_011354_challenge/lag.png

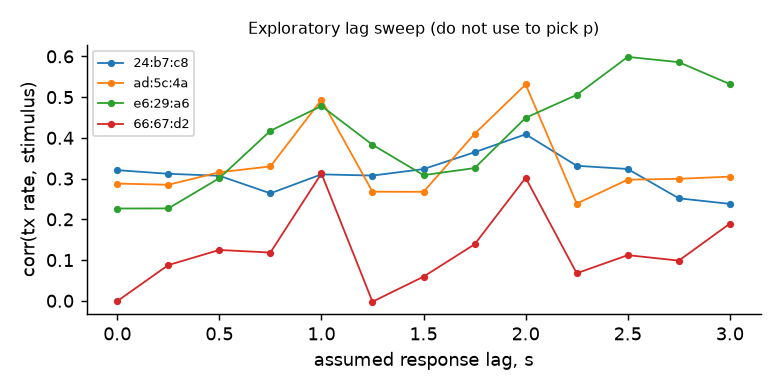
experiments/E2_wifi_traffic/data/20261009_011354_challenge/lag.png
