simu18/SpyScan/experiments/E2_wifi_traffic/data/20261009_011628_challenge/traffic.png

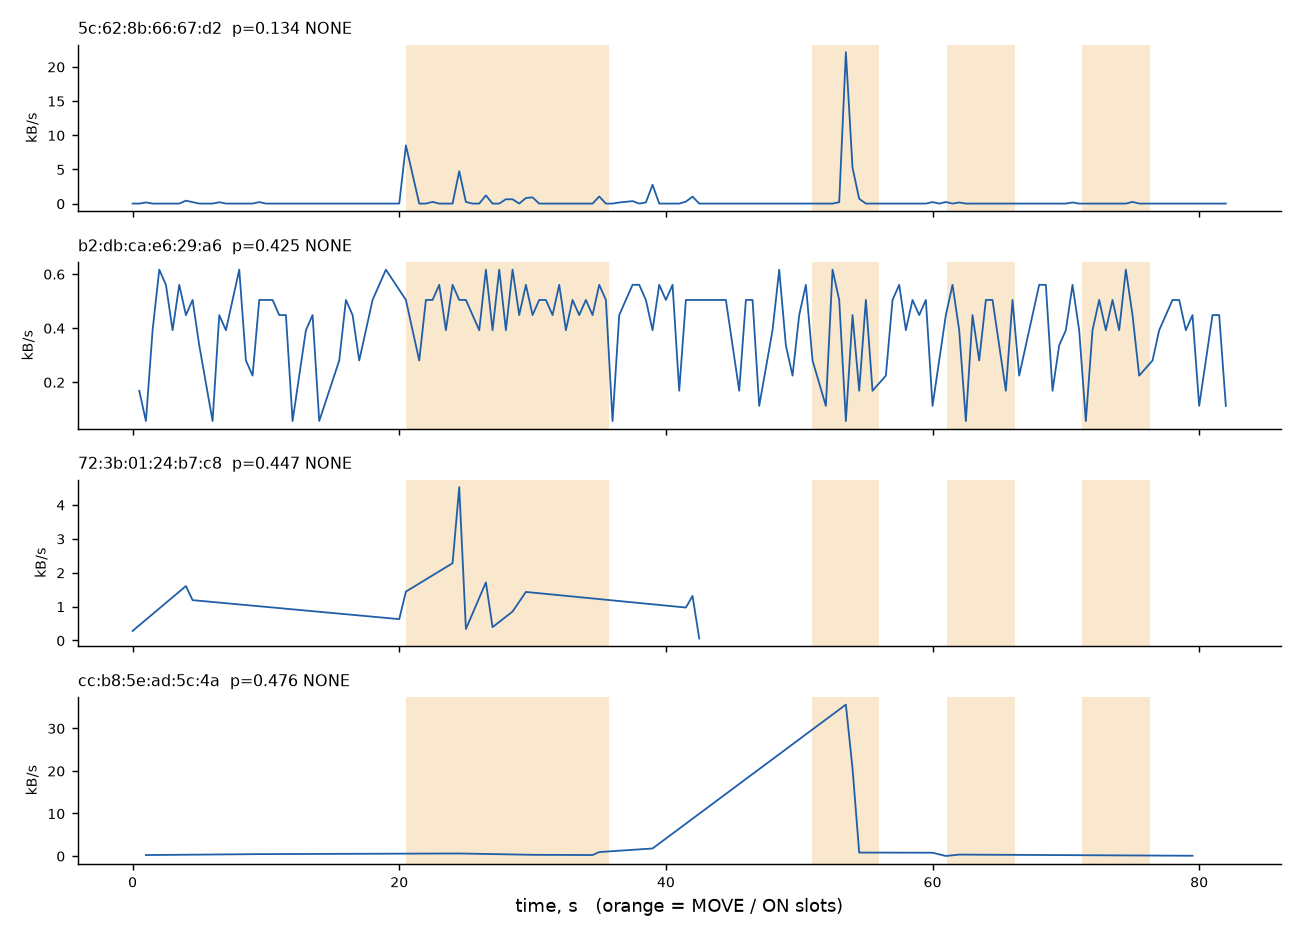
experiments/E2_wifi_traffic/data/20261009_011628_challenge/traffic.png
