simu18/SpyScan/experiments/E2_wifi_traffic/data/20261009_033510_challenge/lag.png

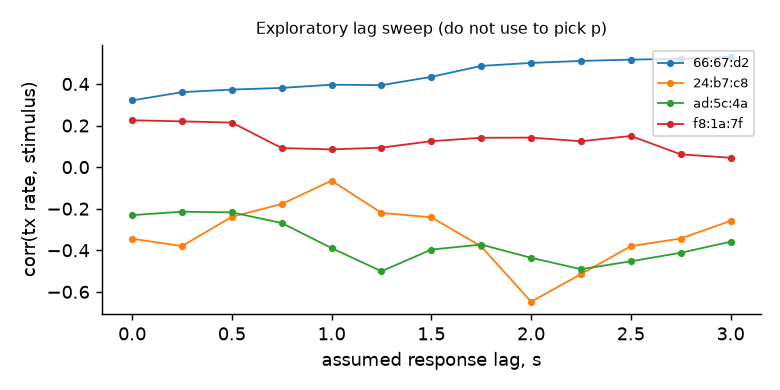
experiments/E2_wifi_traffic/data/20261009_033510_challenge/lag.png
