simu18/SpyScan/experiments/E2_wifi_traffic/data/20261009_034658_record/traffic.png

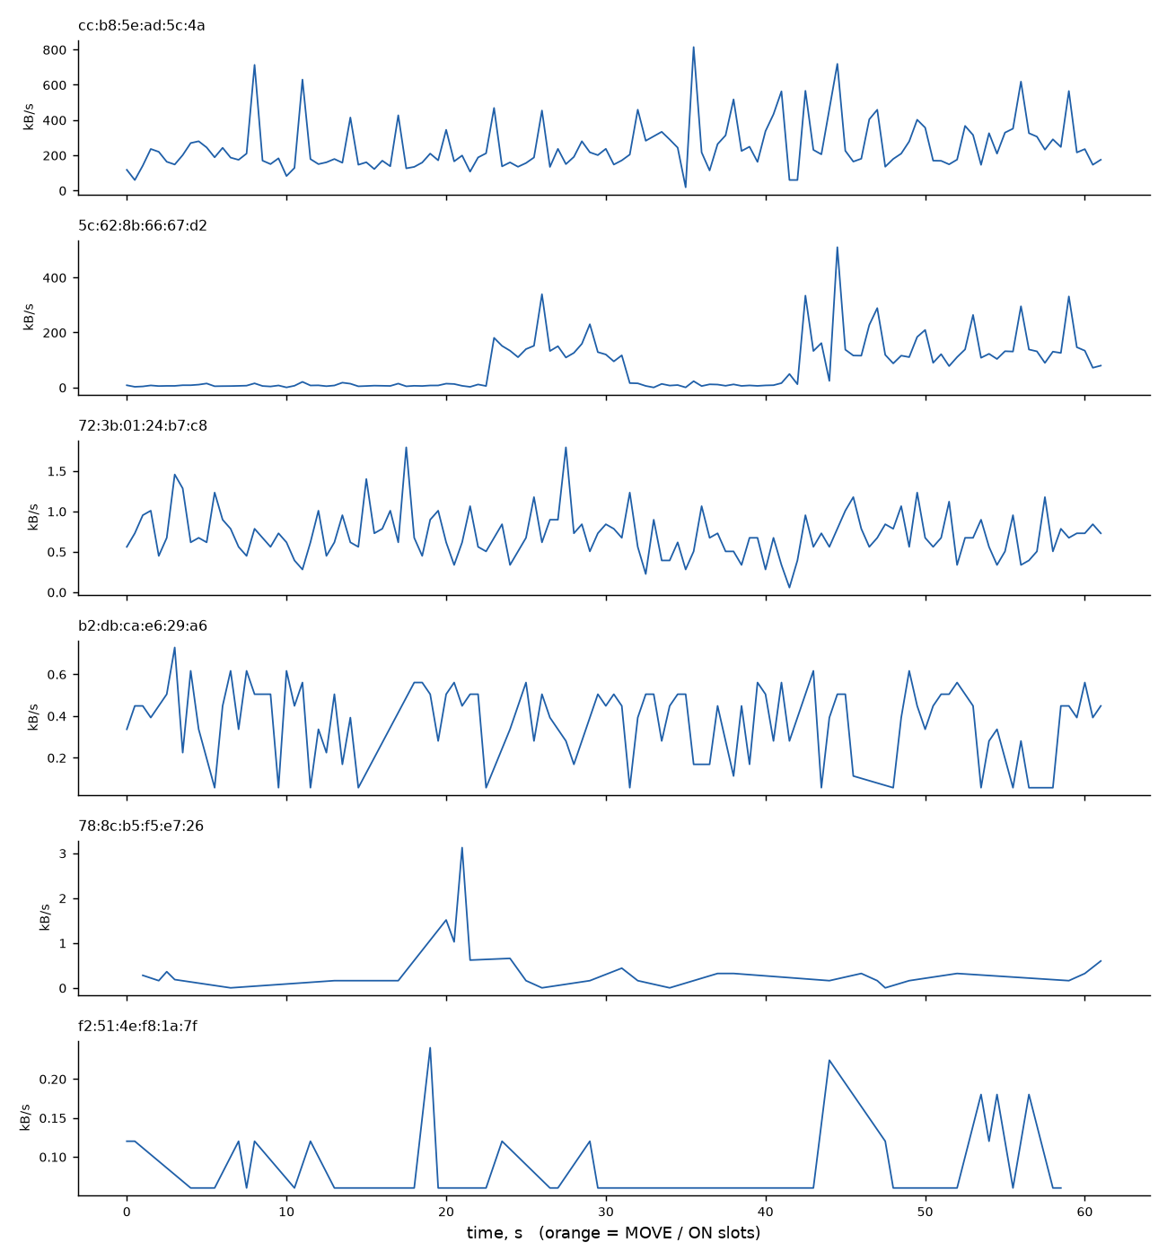
experiments/E2_wifi_traffic/data/20261009_034658_record/traffic.png
