simu18/SpyScan/experiments/E2_wifi_traffic/data/20261009_155601_record/traffic.png

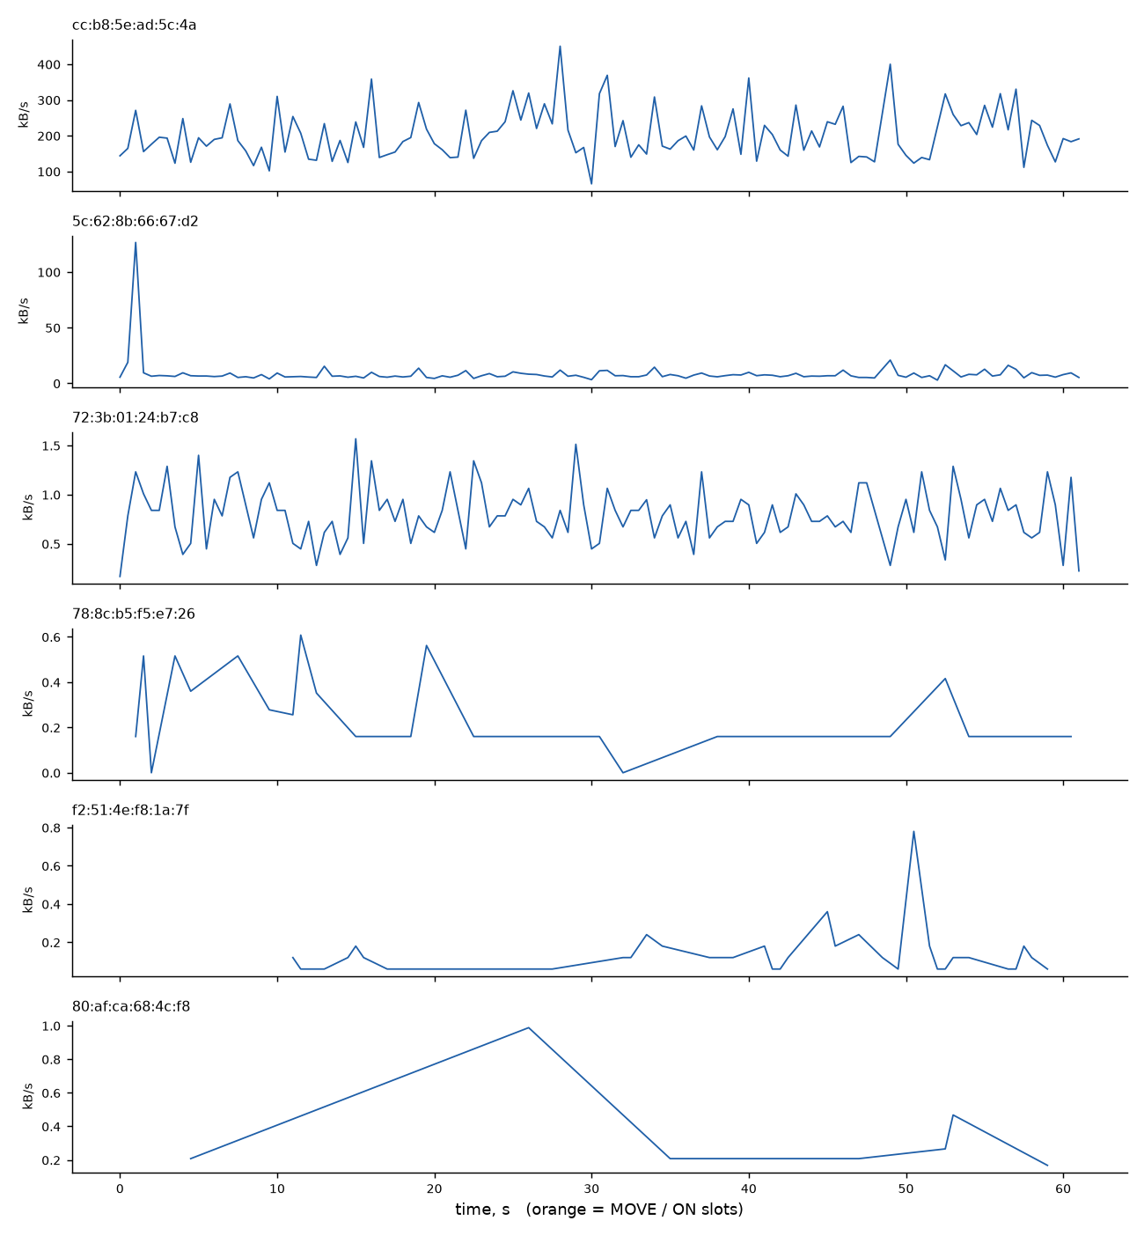
experiments/E2_wifi_traffic/data/20261009_155601_record/traffic.png
