simu18/SpyScan/experiments/E2_wifi_traffic/data/20261009_161944_deauth/traffic.png

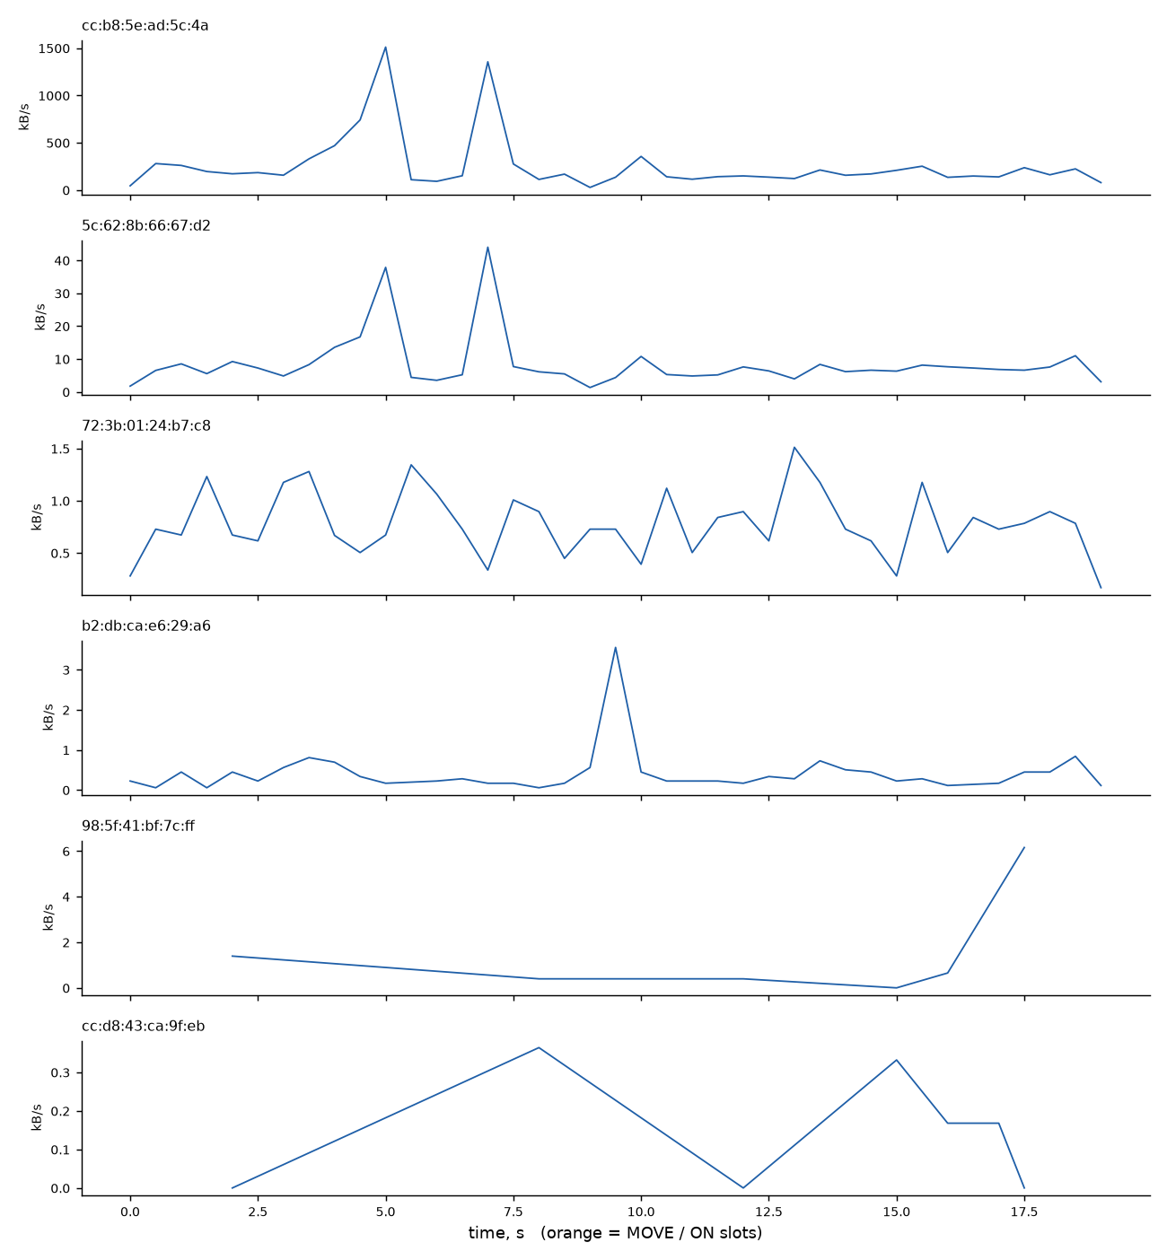
experiments/E2_wifi_traffic/data/20261009_161944_deauth/traffic.png
