simu18/SpyScan/experiments/E2_wifi_traffic/data/20261023_012644_flash_demo/flash_stimulus_response.png

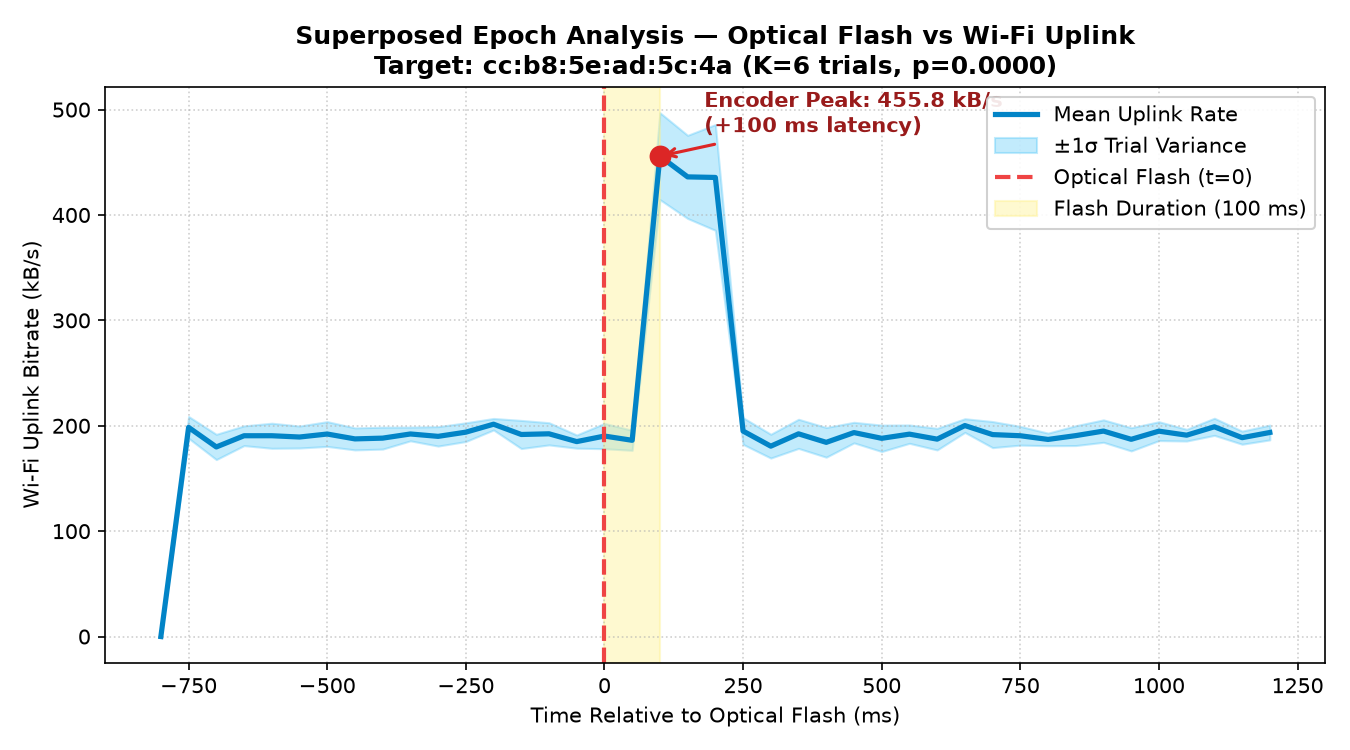
experiments/E2_wifi_traffic/data/20261023_012644_flash_demo/flash_stimulus_response.png
