simu18/SpyScan/experiments/E2_wifi_traffic/data/20261023_023756_flash_stimulus/flash_stimulus_response.png

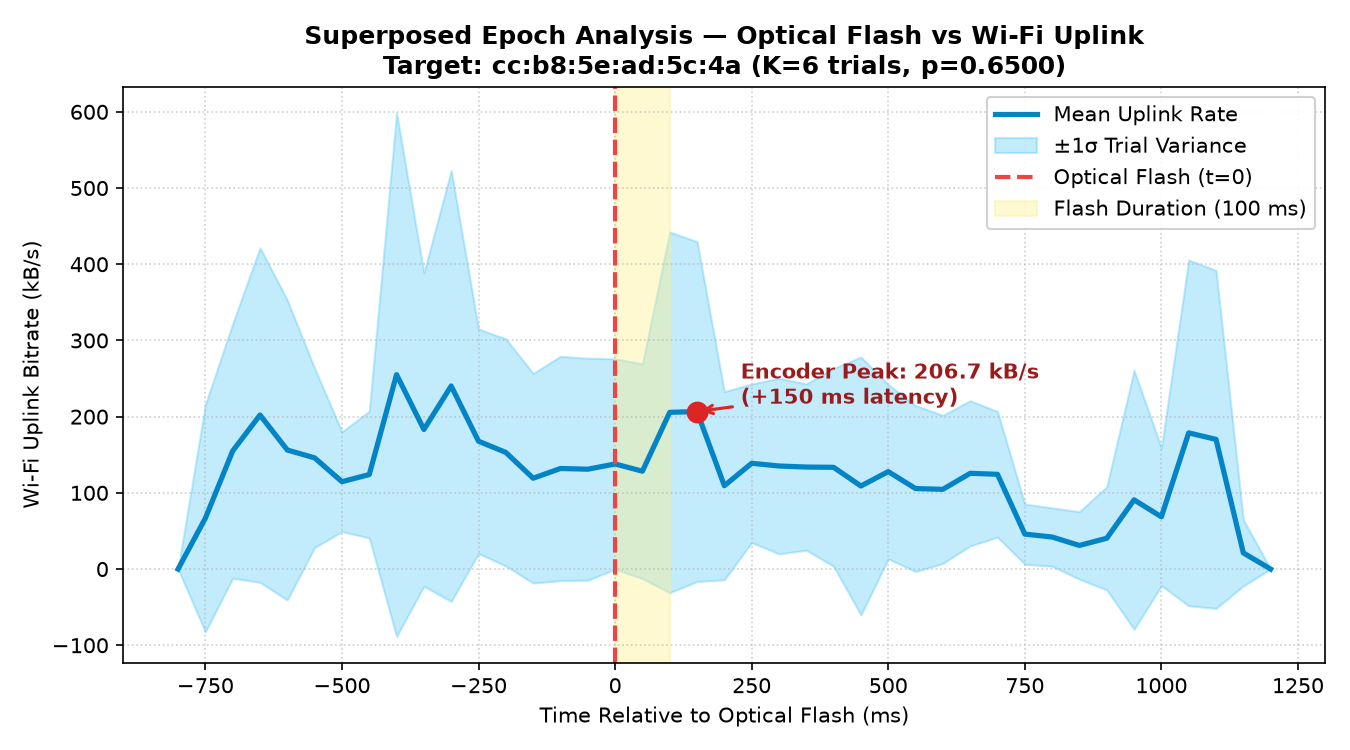
experiments/E2_wifi_traffic/data/20261023_023756_flash_stimulus/flash_stimulus_response.png
