simu18/SpyScan/experiments/E2_wifi_traffic/data/20261023_030848_flash_stimulus/flash_stimulus_response.png

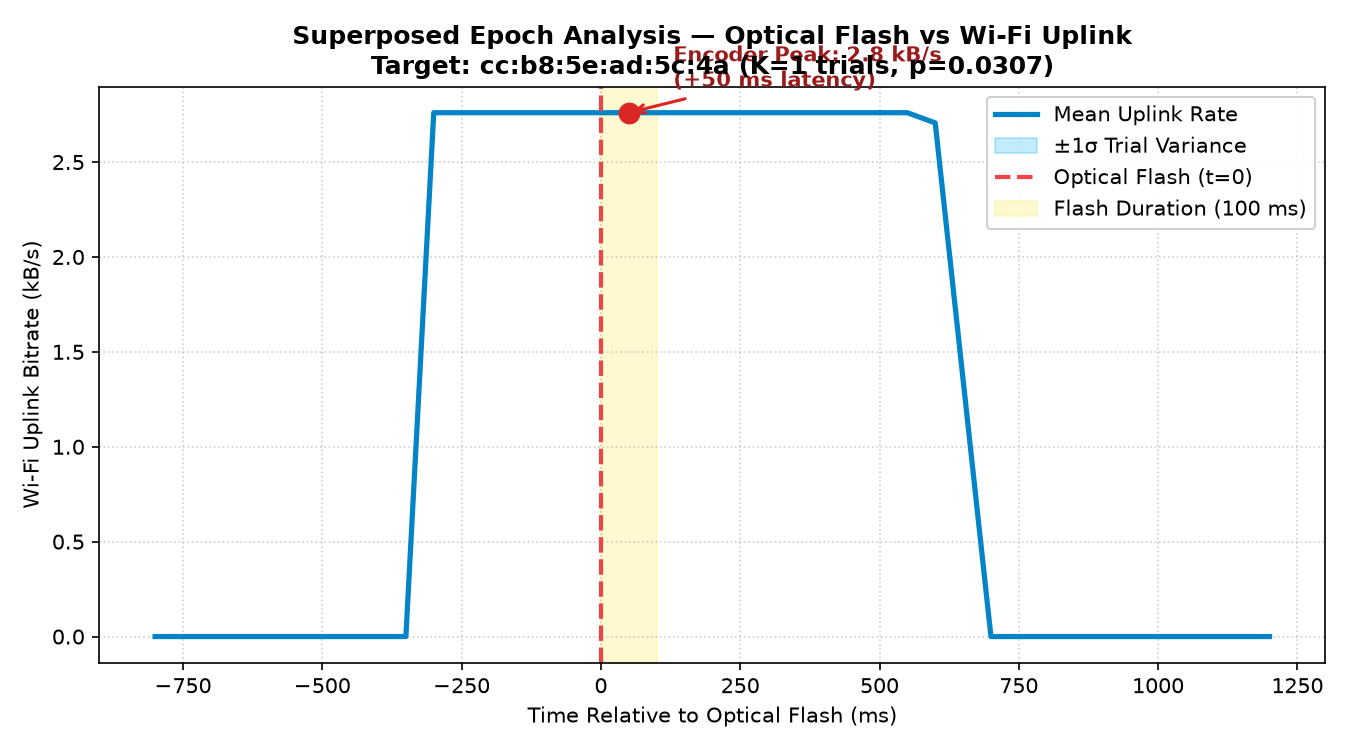
experiments/E2_wifi_traffic/data/20261023_030848_flash_stimulus/flash_stimulus_response.png
