simu18/SpyScan/tools/e2/e2_analyze.py

#!/usr/bin/env python3
"""SpyScan E2 — analysis of a capture folder (raw.csv + meta.json).

  python tools/e2/e2_analyze.py experiments/E2_wifi_traffic/data/<run>

Writes into the run folder:
  devices.csv     per-MAC totals (tx/rx rate, frames, RSSI, role, vendor hint)
  aps.csv         access points seen (BSSID, SSID, channel)
  results.csv     challenge only: per-MAC correlation, permutation p, level, role
  RESULTS.md      human-readable summary (paste into experiments/E2_*/RESULTS.md)
  traffic.png     challenge/record: tx rate of the busiest devices + stimulus shading
  lag.png         challenge only: correlation vs. assumed response lag (exploratory)

Statistics (identical to the firmware module challenge.c):
  x_k = uplink (tx) bytes/s of a device in slot k, s_k in {0,1}
  S   = Pearson corr(x, s); p = (1 + #{S_perm >= S}) / (1 + N_perm), balanced permutations
  HIGH p < 0.01, LOW p < 0.05, else NONE (two-sided since protocol v0.2; the sign of S
  tells whether the rate rose or fell during ON slots).  The lag is fixed BEFORE looking at the data
  (default 0 s); the lag sweep is exploratory and must not be used to pick the p-value.
"""
import csv
import io
import json
import pathlib
import sys

import numpy as np
import pandas as pd

N_PERM = 10000
P_HIGH, P_LOW = 0.01, 0.05
MIN_FRAMES = 50
# Passive "continuous uplink streamer" signature (proposed 2026-10-08 from 8 A9 runs + 2
# non-camera runs). Thresholds were chosen AFTER seeing those runs -> they must be
# validated on new, independent runs before being reported as a detection rate.
SIG_MIN_UP_kBps = 10.0     # mean uplink
SIG_MIN_DUTY = 0.90        # fraction of 1 s windows with uplink > 10 kB/s
SIG_MAX_CV = 0.50          # std/mean of uplink in 5 s windows (v2: was 1 s windows, which
                           # missed a camera with a 3 s keyframe period - camera 2, 2026-10-09)
SIG_CV_WIN_S = 5
SIG_MIN_RATIO = 0.90       # up / (up + down)
SIG_MIN_DUR_S = 30          # devices with fewer transmitted frames in the run are ignored

# Small OUI hint table (first 3 bytes). A hint only — never evidence by itself.
OUI = {
    "24:6f:28": "Espressif", "30:ae:a4": "Espressif", "3c:71:bf": "Espressif",
    "a4:cf:12": "Espressif", "84:f3:eb": "Espressif", "ec:fa:bc": "Espressif",
    "7c:df:a1": "Espressif", "34:85:18": "Espressif", "48:27:e2": "Espressif",
    "50:c7:bf": "TP-Link", "f4:f2:6d": "TP-Link", "ec:08:6b": "TP-Link",
    "3c:a9:f4": "Intel", "00:1b:21": "Intel",
}


def vendor(mac: str) -> str:
    first = int(mac[:2], 16)
    if first & 0x02:
        return "(random)"
    return OUI.get(mac[:8].lower(), "")


def load(run: pathlib.Path):
    rows_b, rows_a, rows_m, rows_p, rows_v = [], [], [], [], []
    with open(run / "raw.csv", encoding="utf-8") as f:
        rd = csv.reader(f)
        next(rd, None)
        for host_t, line in rd:
            p = line.split(",")
            try:
                if p[0] == "B" and len(p) >= 11:
                    # fields 11..14 = tx size histogram (<100,100-699,700-1199,>=1200); 0 if absent (old logs)
                    h = [int(p[11 + k]) if len(p) >= 15 else 0 for k in range(4)]
                    rows_b.append((int(p[1]), int(p[2]), p[3], int(p[4]), int(p[5]),
                                   int(p[6]), int(p[7]), int(p[8]), p[9], p[10], *h))
                elif p[0] == "A" and len(p) >= 6:
                    rows_a.append((int(p[1]), int(p[2]), p[3], int(p[4]), ",".join(p[5:])))
                elif p[0] == "M" and len(p) >= 3:
                    rows_m.append((int(p[1]), ",".join(p[2:])))
                elif p[0] == "P" and len(p) >= 3:        # per-packet focus capture
                    rows_p.append((int(p[1]), int(p[2])))
                elif p[0] == "V" and len(p) >= 6:        # WPS vendor IE decode
                    rows_v.append((int(p[1]), int(p[2]), p[3], int(p[4]), ",".join(p[5:])))
            except ValueError:
                continue                          # corrupted line (serial noise)
    b = pd.DataFrame(rows_b, columns=["t_ms", "ch", "mac", "tx_b", "tx_n", "rx_b", "rx_n", "rssi",
                                      "role", "bssid", "h0", "h1", "h2", "h3"])
    a = pd.DataFrame(rows_a, columns=["t_ms", "ch", "bssid", "rssi", "ssid"]).drop_duplicates("bssid")
    m = pd.DataFrame(rows_m, columns=["t_ms", "label"])
    pk = pd.DataFrame(rows_p, columns=["t_ms", "len"])
    v = pd.DataFrame(rows_v, columns=["t_ms", "ch", "mac", "rssi", "info"]).drop_duplicates("mac") if rows_v else pd.DataFrame()
    meta = json.loads((run / "meta.json").read_text()) if (run / "meta.json").exists() else {}
    return b, a, m, meta, pk, v


def device_table(b: pd.DataFrame, dur_s: float, v: pd.DataFrame = None) -> pd.DataFrame:
    if b.empty:
        return pd.DataFrame()
    g = b.groupby("mac")
    d = pd.DataFrame({
        "tx_kBps": g.tx_b.sum() / dur_s / 1000,
        "rx_kBps": g.rx_b.sum() / dur_s / 1000,
        "tx_frames": g.tx_n.sum(),
        "rx_frames": g.rx_n.sum(),
        "rssi_med": g.rssi.apply(lambda r: float(np.median(r[r != 0])) if (r != 0).any() else np.nan),
        "role": g.role.agg(lambda r: r.mode().iat[0]),
        "bssid": g.bssid.agg(lambda r: r.mode().iat[0]),
        "ch": g.ch.agg(lambda r: r.mode().iat[0]),
    })
    v_map = dict(zip(v.mac, v.info)) if (v is not None and not v.empty) else {}
    d["vendor"] = [v_map.get(m, vendor(m)) for m in d.index]
    return d.sort_values("tx_kBps", ascending=False)


def streamer_signature(b: pd.DataFrame) -> pd.DataFrame:
    """Per-device features at 1 s resolution: mean uplink, downlink, uplink ratio,
    duty (share of seconds with > 10 kB/s uplink), CV, and the provisional STREAMER flag."""
    if b.empty:
        return pd.DataFrame()
    t0, t1 = b.t_ms.min(), b.t_ms.max()
    n = int((t1 - t0) // 1000)
    if n < 5:
        return pd.DataFrame()
    rows = {}
    for mac, d in b.groupby("mac"):
        sec = ((d.t_ms - t0) // 1000).astype(int)
        up = d.groupby(sec).tx_b.sum().reindex(range(n), fill_value=0) / 1000
        if up.mean() < 1:
            continue
        dn = d.rx_b.sum() / 1000 / n
        ratio = up.mean() / (up.mean() + dn)
        duty = float((up > 10).mean())
        k = len(up) // SIG_CV_WIN_S
        w = up.values[:k * SIG_CV_WIN_S].reshape(k, SIG_CV_WIN_S).mean(axis=1) if k >= 2 else up.values
        cv = float(w.std() / w.mean()) if w.mean() > 0 else np.inf
        rows[mac] = dict(up=up.mean(), dn=dn, ratio=ratio, duty=duty, cv=cv,
                         streamer=(up.mean() >= SIG_MIN_UP_kBps and duty >= SIG_MIN_DUTY and
                                   cv <= SIG_MAX_CV and ratio >= SIG_MIN_RATIO and n >= SIG_MIN_DUR_S))
    if not rows:                       # nobody uploads >= 1 kB/s (e.g. camera idle)
        return pd.DataFrame()
    return pd.DataFrame.from_dict(rows, orient="index").sort_values("up", ascending=False)


def packet_size_shape(b: pd.DataFrame) -> pd.DataFrame:
    """Fraction of a device's uplink frames in each size bucket (Method 1.3)."""
    if b.empty or "h0" not in b:
        return pd.DataFrame()
    g = b.groupby("mac")[["h0", "h1", "h2", "h3"]].sum()
    tot = g.sum(axis=1).replace(0, np.nan)
    out = pd.DataFrame({"tiny": g.h0 / tot, "small": g.h1 / tot, "mid": g.h2 / tot, "large": g.h3 / tot})
    out["frames"] = g.sum(axis=1)
    # Measured 2026-10-09 (two cameras): a streaming camera's OWN uplink is dominated by
    # max-size (>=1200 B) packets; the tiny ACKs come from the AP, not the camera. Idle
    # phones/plugs send only tiny packets. So the discriminator is the large-packet fraction.
    out["video_like"] = (out.large >= 0.50) & (out.frames >= 200)
    return out[out.frames >= 50].sort_values("frames", ascending=False)


def keepalive_periodicity(b: pd.DataFrame, max_up_kBps: float = 1.0,
                          min_frames: int = 6, max_frames: int = 400) -> pd.DataFrame:
    """Quiet devices that transmit at a near-constant interval (Method 3.2)."""
    if b.empty:
        return pd.DataFrame()
    dur = max((b.t_ms.max() - b.t_ms.min()) / 1000.0, 1e-3)
    rows = {}
    for mac, d in b.groupby("mac"):
        up = d.tx_b.sum() / dur / 1000
        tx = d[d.tx_n > 0]
        n = len(tx)
        if up > max_up_kBps or n < min_frames or n > max_frames:
            continue
        # Coalesce frames into keep-alive EVENTS: a burst of a few frames within 2 s
        # is one NAT keep-alive exchange, so measure the gap between events, not frames.
        ts = np.sort(tx.t_ms.values) / 1000.0
        events = ts[np.concatenate(([True], np.diff(ts) > 2.0))]
        gaps = np.diff(events)
        if len(gaps) < 3:
            continue
        med = float(np.median(gaps))
        iqr = float(np.percentile(gaps, 75) - np.percentile(gaps, 25))
        reg = max(0.0, 1.0 - iqr / med) if med > 0 else 0.0
        rssi = float(np.median(d.rssi[d.rssi != 0])) if (d.rssi != 0).any() else np.nan
        if med >= 1.0 and reg >= 0.5:                 # periodic, at least ~1 s apart
            rows[mac] = dict(n=n, gap=med, regularity=reg, rssi=rssi)
    return pd.DataFrame.from_dict(rows, orient="index").sort_values("regularity", ascending=False) \
        if rows else pd.DataFrame()


def focus_periodicity_md(pk: pd.DataFrame, run, burst_gap_ms: float = 8.0) -> str:
    """Frame-clock fingerprint of the focused device (Method 1.2).

    A video frame leaves the MAC as a short BURST of back-to-back packets (fragments of
    one encoded frame), so individual packet inter-arrivals are dominated by <2 ms
    within-burst gaps. We first collapse packets into bursts (new burst when the gap
    exceeds burst_gap_ms), then the inter-BURST interval reveals the frame cadence.
    Measured 2026-10-09: camera 2 → 40/80 ms (25 fps) clearly; verified against the IAT
    histogram. The '30 Hz spike' often quoted is camera-specific and only visible after
    this burst collapse — raw per-packet FFT is dominated by the within-burst structure.
    """
    t = np.sort(pk.t_ms.values.astype(float))
    t -= t[0]
    span = t[-1] / 1000.0
    if len(t) < 100 or span < 5:
        return ""
    starts = t[np.concatenate(([True], np.diff(t) > burst_gap_ms))]
    ibi = np.diff(starts)                                   # inter-burst intervals, ms
    ibi = ibi[(ibi > 5) & (ibi < 500)]
    if len(ibi) < 20:
        return ""
    # Which standard frame rate best explains the inter-burst intervals?
    FPS = {15: 66.7, 20: 50.0, 24: 41.7, 25: 40.0, 30: 33.3}
    best, best_frac = None, 0.0
    for fps, per in FPS.items():
        frac = float(((ibi > per - 4) & (ibi < per + 4)).mean())      # ±4 ms of 1 or 2 periods
        frac += float(((ibi > 2 * per - 6) & (ibi < 2 * per + 6)).mean())
        if frac > best_frac:
            best_frac, best = frac, fps
    med = float(np.median(ibi))
    md = ("\n## Focused-device frame-clock fingerprint (Method 1.2)\n\n"
          f"- packets: {len(t)} in {span:.0f} s → {len(starts)} bursts ({len(starts)/span:.1f}/s)\n"
          f"- median inter-burst interval: **{med:.0f} ms**\n"
          f"- best-matching frame rate: **{best} fps** "
          f"({best_frac:.0%} of intervals within ±4 ms of 1× or 2× the period)\n\n"
          "*A human, a download or browsing has no tight 25/30 fps burst cadence; a camera does. "
          "Combine with uplink-dominant + large-packet to corroborate.*\n")
    try:
        import matplotlib
        matplotlib.use("Agg")
        import matplotlib.pyplot as plt
        fig, ax = plt.subplots(figsize=(7, 3))
        ax.hist(ibi, bins=np.arange(0, 160, 3), color="#1f5fa8")
        for fps, per in FPS.items():
            ax.axvline(per, color="#e8a33d" if fps == best else "#ccc",
                       ls="--" if fps == best else ":", lw=1)
            ax.text(per, ax.get_ylim()[1] * 0.9, f"{fps}", fontsize=7, color="#666", ha="center")
        ax.set_xlabel("inter-burst interval, ms"); ax.set_ylabel("count")
        ax.set_title(f"frame-clock fingerprint → {best} fps", fontsize=9)
        ax.spines[["top", "right"]].set_visible(False)
        fig.tight_layout(); fig.savefig(pathlib.Path(run) / "periodicity.png", dpi=130); plt.close(fig)
    except ImportError:
        pass
    return md


def slots_from_markers(m: pd.DataFrame):
    """Returns list of (k, s, t_start_ms, t_end_ms)."""
    sl = []
    marks = m.sort_values("t_ms").reset_index(drop=True)
    for i, row in marks.iterrows():
        if row.label.startswith("slot,"):
            _, k, s = row.label.split(",")[:3]
            t_end = marks.t_ms.iat[i + 1] if i + 1 < len(marks) else None
            sl.append((int(k), int(s), int(row.t_ms), t_end))
    return [x for x in sl if x[3] is not None]


def slot_rates(b: pd.DataFrame, mac: str, slots, lag_ms: int = 0, col: str = "tx_b"):
    d = b[b.mac == mac]
    x = []
    for _, _, t0, t1 in slots:
        sel = d[(d.t_ms > t0 + lag_ms) & (d.t_ms <= t1 + lag_ms)]
        x.append(sel[col].sum() / ((t1 - t0) / 1000.0))
    return np.array(x, dtype=float)


def _spearman(a, b):
    ra = np.argsort(np.argsort(a)).astype(float)
    rb = np.argsort(np.argsort(b)).astype(float)
    return corr(rb, ra)


def corr(x, s):
    x = x - x.mean()
    s = s - s.mean()
    den = np.sqrt((x * x).sum() * (s * s).sum())
    return float((x * s).sum() / den) if den > 0 else 0.0


def perm_test(x, s, rng, n=N_PERM, two_sided=True):
    """Permutation p-value. Two-sided by default (protocol v0.2): the direction of the
    response depends on the camera and stimulus (e.g. covering the lens LOWERS the rate)."""
    obs = corr(x, s)
    perms = np.array([rng.permutation(s) for _ in range(n)], dtype=float)
    xc = x - x.mean()
    pc = perms - perms.mean(axis=1, keepdims=True)
    den = np.sqrt((xc * xc).sum() * (pc * pc).sum(axis=1))
    with np.errstate(invalid="ignore", divide="ignore"):
        c = np.where(den > 0, (pc @ xc) / den, 0.0)
    if two_sided:
        p = (1 + int((np.abs(c) >= abs(obs) - 1e-12).sum())) / (1 + n)
    else:
        p = (1 + int((c >= obs - 1e-12).sum())) / (1 + n)
    return obs, p


def _direction(role, lvl, tx_mean, rx_mean):
    """Hypothesis H4: a correlated SOURCE is uplink-dominant, a viewer downlink-dominant."""
    if lvl == "NONE":
        return "-"
    if role == "A":
        return "AP (forwarding)"
    return "SOURCE" if tx_mean > rx_mean else "viewer/relay"


def level(p):
    return "HIGH" if p < P_HIGH else ("LOW" if p < P_LOW else "NONE")


def analyse(run, lag_ms: int = 0, top: int = 6):
    run = pathlib.Path(run)
    b, a, m, meta, pk, v = load(run)
    md = io.StringIO()
    md.write(f"# E2 run `{run.name}`\n\n")
    md.write(f"- mode: **{meta.get('mode', '?')}**, channel: {meta.get('channel', 'hop')}, "
             f"bin: {meta.get('bin_ms', '?')} ms, lines: {meta.get('lines', '?')}\n")
    if meta.get("note"):
        md.write(f"- note: {meta['note']}\n")
    if b.empty:
        md.write("\nNo traffic bins recorded.\n")
        (run / "RESULTS.md").write_text(md.getvalue())
        print(md.getvalue())
        return

    dur_s = max((b.t_ms.max() - b.t_ms.min()) / 1000.0, 1e-3)
    # In survey (hop) mode each channel is observed only ~1/13 of the time, so rates
    # are normalised by the on-channel observation time, not the wall-clock duration.
    obs_s = dur_s / 13.0 if meta.get("mode") == "survey" else dur_s
    dev = device_table(b, obs_s, v)
    dev.to_csv(run / "devices.csv")
    if not a.empty:
        a.to_csv(run / "aps.csv", index=False)

    md.write(f"- duration: {dur_s:.1f} s, devices seen: {len(dev)}, APs: {len(a)}\n")
    if meta.get("mode") == "survey":
        md.write("- survey rates are estimated per on-channel time (duration / 13); "
                 "use `record` on one channel for accurate rates\n")
    md.write("\n")
    md.write("## Busiest transmitters\n\n| MAC | vendor hint | role | ch | tx kB/s | rx kB/s | tx frames | RSSI |\n|---|---|---|---|---|---|---|---|\n")
    for mac, r in dev.head(12).iterrows():
        md.write(f"| `{mac}` | {r.vendor} | {r.role} | {r.ch} | {r.tx_kBps:.2f} | {r.rx_kBps:.2f} | "
                 f"{r.tx_frames} | {r.rssi_med:.0f} |\n")

    if not v.empty:
        v.to_csv(run / "wps_vendors.csv", index=False)
        md.write("\n## Decoded WPS Vendor & Management IEs (Method 1.4)\n\n"
                 "| MAC | Decoded Device Info | ch | RSSI |\n|---|---|---|---|\n")
        for _, r in v.iterrows():
            md.write(f"| `{r.mac}` | {r.info} | {r.ch} | {r.rssi} |\n")

    sig = streamer_signature(b)
    if not sig.empty:
        sig.to_csv(run / "signature.csv")
        md.write("\n## Passive streaming signature (no stimulus needed)\n\n"
                 "| MAC | up kB/s | down kB/s | up ratio | duty >10 kB/s | CV (5 s) | STREAMER |\n"
                 "|---|---|---|---|---|---|---|\n")
        for mac, r in sig.iterrows():
            md.write(f"| `{mac}` | {r.up:.1f} | {r.dn:.1f} | {r.ratio:.2f} | {r.duty:.2f} | {r.cv:.2f} | "
                     f"{'**YES**' if r.streamer else '-'} |\n")
        md.write(f"\nRule (provisional, not yet validated): up ≥ {SIG_MIN_UP_kBps:g} kB/s, duty ≥ {SIG_MIN_DUTY}, "
                 f"CV ≤ {SIG_MAX_CV}, up ratio ≥ {SIG_MIN_RATIO}, duration ≥ {SIG_MIN_DUR_S} s.\n")

    # ---- Method 1.3: tx packet-size shape (needs new firmware; 0s for old logs) ----
    shape = packet_size_shape(b)
    if not shape.empty and shape[["tiny", "mid", "large"]].to_numpy().sum() > 0:
        md.write("\n## Packet-size shape of the uplink (Method 1.3)\n\n"
                 "| MAC | <100 B | 100–699 | 700–1199 | ≥1200 B | video-like? |\n|---|---|---|---|---|---|\n")
        for mac, r in shape.head(8).iterrows():
            md.write(f"| `{mac}` | {r.tiny:.0%} | {r.small:.0%} | {r.mid:.0%} | {r.large:.0%} | "
                     f"{'YES' if r.video_like else '-'} |\n")
        md.write("\n*A streaming camera's own uplink is dominated by max-size (≥1200 B) packets; "
                 "idle phones/plugs send only tiny packets. Provisional: large fraction ≥ 0.5.*\n")

    # ---- Method 3.2: keep-alive periodicity of quiet devices (presence of an idle camera) ----
    ka = keepalive_periodicity(b)
    if not ka.empty:
        md.write("\n## Quiet-device keep-alive periodicity (Method 3.2)\n\n"
                 "A connected-but-idle camera still sends NAT keep-alives at a fixed interval. "
                 "This finds *presence*, not identity (any IoT device may heartbeat).\n\n"
                 "| MAC | frames | median gap s | regularity | RSSI |\n|---|---|---|---|---|\n")
        for mac, r in ka.iterrows():
            md.write(f"| `{mac}` | {int(r.n)} | {r.gap:.1f} | {r.regularity:.2f} | {r.rssi:.0f} |\n")
        md.write("\n*regularity = 1 − (IQR / median gap); near 1 = very periodic.*\n")

    # ---- Method 1.2: per-packet periodicity of a focused device (FFT / ACF) ----
    if not pk.empty and len(pk) > 40:
        md.write(focus_periodicity_md(pk, run))

    slots = slots_from_markers(m) if not m.empty else []
    if meta.get("mode") == "challenge" and slots:
        s = np.array([x[1] for x in slots], dtype=float)
        rng = np.random.default_rng(12345)
        res = []
        for mac, r in dev.iterrows():
            if r.tx_frames < MIN_FRAMES:
                continue
            x = slot_rates(b, mac, slots, lag_ms, "tx_b")
            xr = slot_rates(b, mac, slots, lag_ms, "rx_b")
            S, p = perm_test(x, s, rng)
            on, off = x[s == 1].mean(), x[s == 0].mean()
            res.append(dict(mac=mac, vendor=r.vendor, role_frames=r.role,
                            S=S, p=p, level=level(p),
                            tx_on_kBps=on / 1000, tx_off_kBps=off / 1000,
                            ratio_on_off=(on / off) if off > 0 else np.inf,
                            direction=_direction(r.role, level(p), x.mean(), xr.mean())))
        res = pd.DataFrame(res).sort_values("p") if res else pd.DataFrame()
        res.to_csv(run / "results.csv", index=False)

        md.write(f"\n## Challenge (K = {len(slots)}, T = {meta.get('t_s')} s, lag = {lag_ms} ms, "
                 f"{N_PERM} permutations, two-sided)\n\n")
        md.write(f"Stimulus: `{''.join(str(int(v)) for v in s)}`"
                 f"{'  ·  ground truth: `' + meta['target'] + '`' if meta.get('target') else ''}\n\n")
        md.write("| MAC | vendor | S (corr) | p | level | tx ON kB/s | tx OFF kB/s | ON/OFF | direction |\n"
                 "|---|---|---|---|---|---|---|---|---|\n")
        for _, r in res.iterrows():
            md.write(f"| `{r.mac}` | {r.vendor} | {r.S:+.3f} | {r.p:.4f} | **{r.level}** | "
                     f"{r.tx_on_kBps:.2f} | {r.tx_off_kBps:.2f} | {r.ratio_on_off:.2f} | {r.direction} |\n")
        md.write("\n*Measured data from this run. Levels use the pre-registered lag; "
                 "lag.png is exploratory only.*\n")

        # ---- validity diagnostics (do not change the level, they flag runs to repeat) ----
        md.write("\n## Per-slot uplink (kB/s) and validity checks\n\n")
        md.write("| MAC | " + " | ".join(f"{k}{'*' if s[k] else ''}" for k in range(len(s)))
                 + " | trend ρ | dropouts |\n|---|" + "---|" * len(s) + "---|---|\n")
        warn = []
        for _, r in res.head(4).iterrows():
            x = slot_rates(b, r.mac, slots, lag_ms, "tx_b") / 1000
            rho = _spearman(np.arange(len(x)), x)
            med = np.median(x)
            drops = int((x < 0.2 * med).sum()) if med > 1 else 0
            md.write(f"| `{r.mac}` | " + " | ".join(f"{v:.0f}" for v in x) + f" | {rho:+.2f} | {drops} |\n")
            if med > 5 and abs(rho) > 0.6:
                warn.append(f"`{r.mac}`: strong time trend (ρ = {rho:+.2f}). The stream was ramping up or down, "
                            "so the slots are not exchangeable → repeat with a longer warm-up.")
            if drops:
                warn.append(f"`{r.mac}`: {drops} slot(s) below 20 % of the median → stream dropout or "
                            "band/channel switch during the run.")
        md.write("\n`*` = MOVE/ON slot.\n")
        if warn:
            md.write("\n**Validity warnings:**\n\n" + "".join(f"- {w}\n" for w in warn))

        _plots(run, b, dev, slots, res, top)
    elif meta.get("mode") == "deauth":
        target = meta.get("target", "").lower()
        t_provoke = None
        for _, r in m.iterrows():
            if str(r.label).startswith("deauth_provoke"):
                t_provoke = r.t_ms
                break
        md.write("\n## Active Re-Association Provocation (Method 3.3)\n\n")
        md.write(f"- Target candidate: `{target}`\n")
        if t_provoke and target:
            d_tgt = b[b.mac.str.lower() == target]
            post = d_tgt[d_tgt.t_ms >= t_provoke]
            pre = d_tgt[d_tgt.t_ms < t_provoke]
            if not post.empty and post.tx_n.sum() > 0:
                t_first = post[post.tx_n > 0].t_ms.min()
                latency_ms = max(0, t_first - t_provoke)
                burst_frames = post.tx_n.sum()
                burst_kB = post.tx_b.sum() / 1000.0
                med_rssi = float(np.median(post.rssi[post.rssi != 0])) if (post.rssi != 0).any() else np.nan
                md.write(f"- Reconnection latency: **{latency_ms} ms**\n")
                md.write(f"- Post-provocation frames: **{burst_frames}** ({burst_kB:.1f} kB)\n")
                md.write(f"- Re-association RSSI: **{med_rssi:.0f} dBm**\n")
                md.write("- Verification verdict: **PROVOKED (Station dropped and re-associated)**\n\n")
            else:
                md.write("- Verification verdict: **NO RESPONSE (Target did not transmit post-deauth)**\n\n")
        _plots(run, b, dev, slots, None, top)
    elif meta.get("mode") in ("record", "challenge"):
        _plots(run, b, dev, slots, None, top)

    (run / "RESULTS.md").write_text(md.getvalue())
    print(md.getvalue())


def _plots(run, b, dev, slots, res, top):
    try:
        import matplotlib
        matplotlib.use("Agg")
        import matplotlib.pyplot as plt
    except ImportError:
        return
    macs = list(res.mac.head(top)) if res is not None and len(res) else list(dev.head(top).index)
    if not macs:
        return
    t0 = b.t_ms.min()
    fig, axes = plt.subplots(len(macs), 1, figsize=(10, 1.8 * len(macs)), sharex=True, squeeze=False)
    for ax, mac in zip(axes[:, 0], macs):
        d = b[b.mac == mac].copy()
        d["t"] = (d.t_ms - t0) / 1000.0
        d["w"] = (d.t // 0.5) * 0.5                       # 0.5 s resampling for readability
        r = d.groupby("w").tx_b.sum() / 0.5 / 1000
        ax.plot(r.index, r.values, lw=1.0, color="#1f5fa8")
        for _, s_, ts, te in slots:
            if s_:
                ax.axvspan((ts - t0) / 1000, (te - t0) / 1000, color="#e8a33d", alpha=0.25, lw=0)
        lab = mac
        if res is not None and len(res):
            rr = res[res.mac == mac].iloc[0]
            lab += f"  p={rr.p:.3f} {rr.level}"
        ax.set_ylabel("kB/s", fontsize=8)
        ax.set_title(lab, fontsize=9, loc="left")
        ax.tick_params(labelsize=8)
        ax.spines[["top", "right"]].set_visible(False)
    axes[-1, 0].set_xlabel("time, s   (orange = MOVE / ON slots)")
    fig.tight_layout()
    fig.savefig(run / "traffic.png", dpi=130)
    plt.close(fig)

    if res is not None and len(res) and slots:
        s = np.array([x[1] for x in slots], dtype=float)
        lags = np.arange(0, 3001, 250)
        fig, ax = plt.subplots(figsize=(6, 3))
        for mac in macs[:4]:
            cs = [corr(slot_rates(b, mac, slots, int(l)), s) for l in lags]
            ax.plot(lags / 1000, cs, marker="o", ms=3, lw=1, label=mac[-8:])
        ax.set_xlabel("assumed response lag, s")
        ax.set_ylabel("corr(tx rate, stimulus)")
        ax.set_title("Exploratory lag sweep (do not use to pick p)", fontsize=9)
        ax.legend(fontsize=7)
        ax.spines[["top", "right"]].set_visible(False)
        fig.tight_layout()
        fig.savefig(run / "lag.png", dpi=130)
        plt.close(fig)


if __name__ == "__main__":
    if len(sys.argv) < 2:
        sys.exit(__doc__)
    analyse(sys.argv[1], lag_ms=int(sys.argv[2]) if len(sys.argv) > 2 else 0)
