simu18/SpyScan/(commit log)

2026-10-01 Stage 1: project structure, TZ v2 (problem-driven goal, two methods), work plan, log
2026-10-01 Architecture draft 0.1: HW/SW diagrams, pin map, power budget, RTOS design; Wokwi HMI simulation; PC tests
2026-10-03 fix battery pot default + lowbat debounch
    [sketch.ino]
2026-10-07 all improvment's and fixes for last two days, can't tell what are they
    [e2_analyze.py, e2_capture.py, fake_device.py, sniffer.c]
2026-10-08 uploading testing data
    [aps.csv, devices.csv, raw.csv, results.csv]
2026-10-08 new wifi method: packet size shape, keep-alive peridocoty, focus capture
    [aps.csv, devices.csv, raw.csv, results.csv, signature.csv]
2026-10-09 messed up gitignore
    [aps.csv, devices.csv, raw.csv, results.csv, signature.csv]
2026-10-22 feat(method2): implement passive IR night-vision hunter and 5V IR hardware sensor integration
2026-10-22 fix(optical+wifi): implement dual-LED alternating strobe, boost OV3660 gain, widen lens halo bounds, and add auto-port resolution
2026-11-08 feat(hardware): add master wiring plan, parametric CAD model, 3D printing guide, and printable STLs for Bambu Lab
